dwight9339/spooky_box_proto/host/README.md

# Spooky Bench host utility

Phase 1A provides Windows serial discovery, bounded Pico UART capture and
LOG/DIAG queries on the separate target CDC port. Phase 1B adds pinned Windows
OpenOCD probe/reset and manifest-based paired flashing with integrated UART
capture. Phase 2 adds a supervised `test boot-smoke` verdict for an IpcSmoke
pair. Phase 3 adds a supervised `test ipc-load` recording workload,
`wav inspect` for CRC-verified retrieval and local three-channel analysis, and
`wav align` for offline radio-to-microphone timing measurement, and `test sd-basic`
for bounded scratch-file write/read verification with cleanup. `test
recording-regression` composes flash, recording, retrieval and health checks into
the single unattended baseline regression. See
[controls](../docs/procedures/spooky-bench-controls.md),
[boot smoke](../docs/procedures/spooky-bench-boot-smoke.md), and
[IPC load](../docs/procedures/spooky-bench-ipc-load.md), and
[WAV inspection](../docs/procedures/spooky-bench-wav-inspection.md),
[WAV alignment](../docs/procedures/spooky-bench-wav-alignment.md),
[SD basic](../docs/procedures/spooky-bench-sd-basic.md), and
[recording regression](../docs/procedures/spooky-bench-recording-regression.md). Run
`spookybench --json ...` for one machine-readable result.

`diag identity` reads the M7-reported build token, retained boot epoch, reset flags
and compatible capability bits. New manifests compare that observation with the
identity embedded in the staged CM7 ELF; legacy schema-v1 images remain supported
with target identity explicitly unavailable.

See [installation and usage](../docs/procedures/spooky-bench-setup.md) and the
[implementation plan](../docs/history/2026-09-23-spooky-bench-plan.md).

Tests use simulated devices; no board connection is required:

```powershell
host/.venv/Scripts/python.exe -B -m unittest discover -s host/tests -v
```

The environment must include the pinned Spookyprobe package. The setup procedure
exports its committed source without modifying the sibling repo. Tests do not
depend on that repo remaining present once the package is installed.
