dwight9339/spooky_box_proto/docs/design/usb-cli.md

# USB CDC CLI contract

The command interface on the target's USB CDC port. It is a bring-up implementation of
the application command model in the [architecture](architecture.md#application-model):
physical controls will eventually use the same command handling and safety policy.
Wiring and device configuration are in [prototype hardware](prototype-hardware.md).
Diagnostic commands (`LOG`, `DIAG`) are specified in
[Spookyprobe v1](spookyprobe-v1.md); `IPC STATUS` in the
[diagnostic IPC contract](ipc-diagnostic-contract.md).

## Transport

The port enumerates as a CDC ACM device, distinct from the Spooky Probe's serial port.
Windows may display it as `USB Serial Device`. The baud-rate setting is ignored. On
connection it prints:

```text
Spooky Box USB CLI ready
Type HELP for commands.
```

Commands are ASCII lines terminated by CR, LF, or CRLF:

```text
HELP
STATUS
BAND
BAND FM
BAND AM
BAND SW
BAND LW
TUNE 99100
UP
DOWN
CLASSIC
CLASSIC RUN
CLASSIC PAUSE
CLASSIC TOGGLE
CLASSIC DIR
CLASSIC RATE +1
CLASSIC DIST -2
CLASSIC EDGE 1
VOLUME READ
MAG READ
MAG STATUS
MAG STREAM START 100
MAG STREAM STOP
EMF READ
EMF STATUS
EMF ZERO
EMF STREAM START 100
EMF STREAM STOP
RECORD STATUS
RECORD RESULT
RECORD TIMELINE
RECORD LATENCY
RECORD START 60
RECORD STOP
SD STATUS
SD INFO
SD REINIT
SD STRESS 64 1
SD STRESS STOP
SD CLEAN
SD FORMAT
SD FORMAT CONFIRM
WAV FETCH FIELD/F0001/AUDIO000.WAV
WAV ABORT
UI STATUS
UI WATCH START
UI WATCH STOP
UI LEDS
UI MATRIX PROBE
UI MATRIX ANIMATE
UI MATRIX ORIENT
UI MATRIX FEEDBACK
UI MATRIX FEEDBACK ON
UI MATRIX FEEDBACK OFF
UI MATRIX TRAIL ON
UI MATRIX TRAIL OFF
UI DISPLAY TEST
UI DISPLAY TEST 0
UI DISPLAY TEST 2
UI DISPLAY OFF
UI OFF
SLEEP START
DIAG IDENTITY
DIAG LATENCY
```

HELP is streamed in short lines.

## Command input and flow control

Commands are lines of at most 63 characters, ended by CR or LF. The firmware handles
one line per foreground pass, and only once the previous reply has gone out. Received
bytes wait in a 256-byte ring. The CDC OUT endpoint is re-armed only while another
full 64-byte packet fits in it; otherwise the device NAKs the host, which holds its
data until the firmware has drained the ring (`full_spooky_proto-8lw.24`). A client
that sends faster than the firmware answers is slowed down instead of losing bytes, so
every complete line it sends gets exactly one reply. A line longer than 63 characters is
answered `ERR command too long`. While the endpoint is paused, the host retries
continuously. The HAL enables an interrupt for every NAKed OUT token; the firmware masks
it when the interface is configured, so a pause costs no CPU. Unmasked, those
interrupts starved a recording into an overrun during a command flood
([evidence](../evidence/2026-10-02-usb-flow-hostless-battery.md)).

`DIAG USB` reports the receive counters since the last enumeration:

```text
OK DIAG USB RX_PACKETS=... RX_PAUSES=... RX_OVERRUNS=0 RX_QUEUED=... RX_PAUSED=0|1
```

`RX_PAUSES` counts how often flow control held the host back. `RX_OVERRUNS` counts
packets that did not fit and were truncated; it stays zero unless flow control fails.

## Target build identity

`DIAG IDENTITY` is a bounded read-only query owned by M7. Its single response is:

```text
OK IDENTITY V=1 CORE=7 BUILD=<token> BOOT=<u32> RESET=<u32> CAPS=<u32>
```

`BUILD` is the 1..128 character ASCII token supplied as `SPOOKY_BUILD_ID` when the
paired firmware was configured. `BOOT` is a nonzero counter retained in RTC backup
registers and advanced once per M7 startup; a changed value during one bench
operation proves that the target restarted. It is not a globally unique boot ID and
may restart after loss or reset of the backup domain. `RESET` is the startup snapshot
of `RCC_RSR`, taken before firmware clears the reset flags.

`CAPS` bit 0 declares identity reporting, bit 1 the retained boot epoch, bit 2 the
diagnostic service, bit 3 WAV protocol v1, and bit 4 the opt-in IPC smoke service.
Consumers must reject unsupported schema/core values and must not infer target or
probe firmware identity from USB descriptors or package versions.

## Command admission while recording

The CLI and future physical-control commands share the recording-safe policy from
[decision 0008](../decisions/0008-recording-safe-command-policy.md). `RECORD START`
and `RECORD STOP` are admitted to the bounded M7 event queue as external commands;
if its non-reserved capacity is exhausted, the CLI replies `ERR BUSY` and changes
nothing. Session actions then run through the authoritative Session machine.

`DIAG LATENCY` streams the recording-only maximum and violation count for every
foreground service. The budget table and queue-headroom rationale are in
[foreground latency](foreground-latency.md).

While Preparing, Recording or Finalizing, sleep, another recording start, SD maintenance, WAV
transfer, `EMF ZERO`, the `UI LEDS`, `UI MATRIX ANIMATE`, `UI MATRIX ORIENT`,
`UI MATRIX FEEDBACK ON` and `UI DISPLAY TEST` patterns, and radio band changes (except in the `BandSwitchQual` preset) are rejected before their service handlers
run. Status and diagnostic reads, `CLASSIC` parameter commands and `MONITOR PTT` remain available. Every policy rejection is a
numeric `COMMAND_REJECTED` diagnostic and returns one stable `ERR` line. No command
is deferred until the recording ends.

## Radio

`BAND` reports the current receiver band and its tuning range. `BAND FM`,
`BAND AM`, `BAND SW`, and `BAND LW` switch receiver function, restore the last
frequency used in that band, and briefly mute the headphones while the Si4735
is power-cycled. The defaults, ranges, and `UP`/`DOWN` increments are:

| Band | Default | Range (kHz) | Step |
| --- | ---: | ---: | ---: |
| FM | 99100 kHz | 87500..108000 | 100 kHz |
| AM | 1000 kHz | 520..1710 | 10 kHz |
| SW | 6000 kHz | 2300..23000 | 5 kHz |
| LW | 198 kHz | 153..279 | 9 kHz |

The antenna path follows the band automatically. `TUNE` always accepts an integer
frequency in kHz. The Radio machine validates it against the band the tune will run
in, so a `TUNE` sent right after a `BAND` command is checked against the new band;
FM values are rounded to the Si4735's nearest 10 kHz command unit. A successful tune returns the band, actual
frequency, RSSI, SNR, and valid-channel flag, for example:

```text
OK RADIO BAND=FM FREQ=99100 kHz (99.100 MHz) RSSI=7 SNR=2 VALID=0
```

`TUNE`, `UP`, `DOWN` and `BAND <band>` go to the Radio machine
([RadioSm](behavior/RadioSm.puml)) through the bounded M7 event queue. If the queue
refuses the command, the reply is `ERR BUSY` and nothing changes. Otherwise the reply
comes when the command's outcome is known: neither a tune nor a band switch holds
the CLI or the foreground loop while the receiver settles or power-cycles. One tune
or band switch is in flight at a time, and one newer command waits behind it. A command that arrives while another is waiting
replaces it, and the replaced command is answered `OK RADIO SUPERSEDED`, so a client
that streams targets (for example a Pd slider) gets exactly one reply per line and
no backlog builds up. Other replies are `ERR RADIO tune failed` (bus error, or no
completion within 2 s), `ERR RADIO abandoned; radio fault` for a command still
waiting when the radio faults, and `ERR RADIO audio path is not running` once the
radio is out of service. A `TUNE` that waits behind a band switch is checked
against the new band when the switch completes.

A band switch that fails holds the receiver in reset and keeps the output muted. Radio
capture keeps running with silence in the radio channels, so a recording in progress
continues with its microphone track and an open gap
([decision 0004](../decisions/0004-radio-track-continuity-across-transitions.md)).
Until a reset, `STATUS` and every radio command answer
`ERR RADIO band switch failed; reset required`, a `RADIO_FAULT` diagnostic sets
`HAS_FAULT`, and `RECORD START` is refused with `ERR RECORD radio audio path is not
running`.

In-band tuning (`TUNE`, `UP`, `DOWN` and Classic's jumps) is allowed while
recording ([decision 0003](../decisions/0003-radio-control-during-recording.md);
[evidence](../evidence/2026-10-16-tune-guard-lift.md)). Each tune is stored in the
session's event log, and the radio track inside a retune interval holds receiver output
that is not a measurement ([decision 0015](../decisions/0015-raw-radio-track-during-in-band-tunes.md)).
Band changes are still rejected while recording, with
`ERR RADIO band changes disabled while recording`, until `full_spooky_proto-54w.12`
qualifies them. The opt-in `BandSwitchQual` preset allows them while recording, for
that qualification only. It also accepts `BAND FAIL`, which makes the next band switch
fail after its receiver power-up command, as if the receiver had answered an error;
the reply is `OK RADIO next band switch fails at POWER_UP`.

During a band switch the audio path's stream gate is closed. Each radio half-buffer
then reaches the recorder as digital silence of the same length, so the radio and
microphone tracks keep the same block count. The monitor plays silence, and the
activity detector gets no measurement
([decision 0004](../decisions/0004-radio-track-continuity-across-transitions.md)).
When the gate reopens, the gap's first and last silenced frames are exact.

- **Session event log:** gap start (band before) and gap end (band after and
  frequency).
- **UART log:**

```text
[gap] start=1:5120000 end=1:5135359 band=FM->AM freq=1000 missed=0
```

`missed` counts gaps whose edges were overwritten before the foreground saw them.

The radio is also tuned by the Classic scan engine, which runs from power-on (next
section). Band and frequency are shared: a CLI `TUNE`, `UP`, `DOWN` or `BAND` moves
them, and a running Classic continues from wherever the CLI tuned. Classic waits for
every CLI radio command to be answered before it computes its next jump. A bench step
that needs a fixed frequency sends `CLASSIC PAUSE` first.

## Classic scan engine

The device boots with the Classic engine running on FM
([spec 001](../../spec/specs/001-classic-scan-engine/spec.md),
[decision 0016](../decisions/0016-classic-scan-motion.md)). Until physical controls
are wired, the CLI issues the same Classic commands as the controls of the control
map, through the bounded M7 event queue:

| Command | Effect | Control |
|---|---|---|
| `CLASSIC` | Report the published state | |
| `CLASSIC TOGGLE` | Run or pause | C-103 |
| `CLASSIC RUN`, `CLASSIC PAUSE` | Run or pause; no change if already in that state | |
| `CLASSIC DIR` | Toggle the scan direction | C-105 |
| `CLASSIC RATE <n>` | Move the jump rate `n` detents (signed) | C-104 |
| `CLASSIC DIST <n>` | Move the current band's jump distance `n` detents | C-106 |
| `CLASSIC EDGE <n>` | Move the edge behavior `n` detents through wrap, bounce, stop | C-110 |
| `CLASSIC HOLD <n>` | Move the activity hold time `n` detents through 0 (off), 1, 2, 3, 5, 8, 10, 15, 20 and 30 s | C-111 |
| `CLASSIC ACTIVITY` | Report the radio onset measurement behind the hold (bench diagnostic) | |

Each command is answered after it is applied, with the state, and `CLASSIC` reports
the same line:

```text
OK CLASSIC STATE=RUNNING REASON=NONE BAND=FM FREQ=99100 CH=116/206 DIR=UP RATE=120 SET=120 LIMITED=0 DIST=1 DIST_KHZ=100 EDGE=WRAP HOLD=0 JUMPS=0 REFUSED=0 FAILED=0 HOLDS=0
```

`STATE` is `RUNNING`, `HOLDING`, `PAUSED`, `SWEEP_COMPLETE` or `UNABLE`. `UNABLE`
replaces `RUNNING` and `HOLDING` while Classic cannot retune, and `REASON` says why:
`RADIO_STOPPED`, `RADIO_FAULTED`, or `SESSION` while the command policy rejects tuning
during a session. Classic then issues nothing and does not retry; it resumes one jump
period after tuning is possible again. `RATE` is the rate in effect and `SET` the
setting; `LIMITED=1` means the band's maximum rate applies. `FREQ` and `CH` are the
last completed tune. `HOLD` is the hold time in seconds, 0 when off. `JUMPS` counts
jumps, `REFUSED` tune commands the queue refused (the landing waits one period),
`FAILED` tunes answered as failed, rejected, superseded or abandoned, and `HOLDS`
holds started. A full queue answers `ERR BUSY` and malformed arguments the usage
line. Classic commands are allowed during a session.

`HOLDING` means Classic is staying on its landing because the radio audio has onsets
(decision 0016 items 17 to 20): a hold starts on an onset of at least medium size,
lasts while onsets of any size follow within 1.5 s, ends at the hold time at most,
and happens at most once per landing. A hold never shortens a dwell: when it ends
before the next jump is due, the jump keeps its time. Onsets come from the decision
0013 detector, fed one level per radio half-buffer; from each tune or band switch
until the radio is seen settled, plus one half-buffer except after FM and AM tunes,
blocks are not measured
([decision 0015](../decisions/0015-raw-radio-track-during-in-band-tunes.md)), so no
hold starts there. `CLASSIC ACTIVITY` replies:

```text
OK CLASSIC ACTIVITY VALID=1 RETUNING=0 RATIO_X100=104 ONSETS=12/3/1 BLOCKS=56230 MEASURED=55120 DROPPED=0 HIGH=5 RETUNES=310
```

`VALID=1` means the latest radio block was measured and arrived within 100 ms.
`RETUNING=1` while a retune interval is open. `RATIO_X100` is the detector's
fast/slow level ratio times 100. `ONSETS` counts small, medium and large onsets since
boot. `BLOCKS` and `MEASURED` count half-buffers given to the detector and those
measured. `DROPPED` counts half-buffers the 32-entry feed refused because the
foreground had not drained it, and `HIGH` is the most waiting at once. `RETUNES`
counts retune intervals started.

Every change of run state (with its reason), direction (including a bounce reversal),
rate, distance, edge behavior or hold time is published as one line on the AUX UART
log, with the millisecond tick and the radio sample-timeline position as `epoch:frame`
([decision 0012](../decisions/0012-common-audio-sample-timeline.md)):

```text
[classic] t=48211 pos=1:2312448 DIRECTION STATE=RUNNING REASON=NONE DIR=DOWN RATE=120/120 LIMITED=0 DIST=1 EDGE=BOUNCE HOLD=0 BAND=FM FREQ=107900
```

Routine jumps are not events; each completed tune is logged by the radio as usual. A
hold is two `RUN_STATE` lines, `STATE=HOLDING` and then `STATE=RUNNING` (or
`PAUSED`), whose ticks give its length. Each radio onset the Classic service receives
is also logged, with the frequency of the last completed tune, whether or not the
hold is on, so a bench trial can see where onsets fall (decision 0016 item 23):

```text
[activity] t=27347 ONSET=SMALL BAND=FM FREQ=89200
```

## Volume

The wheel potentiometer is sampled every 10 ms. Firmware applies a low-pass filter and
one-dB update hysteresis, maps the knob from mute through 0 dB headphone gain, and
continues to honor the headphone jack detect. `VOLUME READ` (also accepted as
`VOLUME` or `VOLUME STATUS`) forces a fresh ADC sample and reports its current level:

```text
OK VOLUME ADC=32768 LEVEL=50% ATTEN=-26.5 dB MUTED=0
```

## Monitor and PTT

The headphone monitor plays the radio. PTT (C-016, C-017; decision 0028) fades the
radio out of the monitor over `SPOOKY_PTT_RAMP_FRAMES` (240 frames, 5 ms) and back in
on release; both raw tracks keep recording unchanged. The microphone is not monitored.
`MONITOR PTT ON` and `MONITOR PTT OFF` set PTT through the same command-policy action
as Button 1, allowed in every session state. A CLI press is not reconciled: it lasts
until `MONITOR PTT OFF`. Repeating the current state changes nothing. `MONITOR` (or
`MONITOR STATUS`) reports, and each `MONITOR PTT` command replies with the same line:

```text
OK MONITOR PTT=1 GAIN_Q15=0 RAMP_FRAMES=240 MIC=OFF PRESSES=3 RELEASES=2 UNSTAMPED=0 LAST_ON=1:1843200 LAST_OFF=1:1795584 UNCERTAINTY=3600
```

| Field | Meaning |
| --- | --- |
| `PTT`, `GAIN_Q15` | PTT is on; the radio's monitor gain now, 32768 unity and 0 silent |
| `RAMP_FRAMES`, `MIC` | Frames of a full fade; the microphone is not in the monitor |
| `PRESSES`, `RELEASES` | PTT changes since boot |
| `UNSTAMPED` | Changes made while the radio stream was not running, so not stamped |
| `LAST_ON`, `LAST_OFF` | The latest press and release as `epoch:frame` on the radio timeline (decision 0012), `NONE` before the first |
| `UNCERTAINTY` | Frames before the stamp in which the change may have happened: one foreground pass (decision 0012 item 6). It excludes the input path's own latency |

Sessions do not store PTT stamps yet; that belongs to the session format
(`full_spooky_proto-hpq.3`).

## Magnetometer and EMF

`MAG READ` wakes the sensor, returns one X/Y/Z result in microtesla plus raw
codes and conversion status, then puts it back to sleep. `MAG STREAM START`
starts a 100 ms stream; an optional period from 50 through 60000 ms can be
provided after `START`. `MAG STREAM STOP` stops the stream and returns the
sensor to sleep. At boot, firmware prints one sample. Example output:

```text
OK MAG STREAM START period=100 ms
MAG X=24uT Y=-48uT Z=101uT RAW=6,-12,25 SET=3 READY=1 DIAG=0
OK MAG STREAM STOP; sensor sleeping
```

The prototype `EMF` value is a magnetic anomaly metric, not electromotive force in
volts. It is the absolute difference between the 3D field magnitude and a slowly
adapting ambient baseline:

```text
EMF = abs(sqrt(X*X + Y*Y + Z*Z) - baseline)
```

The initial boot sample seeds the baseline. A low-duty background reading
updates it every five seconds by 1/16 of the difference, giving an effective
time constant of roughly 80 seconds, but only while the field is quiet: when
the change from baseline is 100 µT or more the update is skipped
([decision 0019](../decisions/0019-matrix-emf-four-buckets-and-quiet-baseline.md)).
This follows slow ambient drift, and a magnet held near the sensor cannot drag
the baseline and leave a false reading once it is taken away. A lasting change
of 100 µT or more stays shown until `EMF ZERO`. `EMF READ` returns only the single
metric, `EMF STATUS` also shows the current magnitude and baseline, and
`EMF ZERO` immediately resets the baseline to the current field. The EMF
stream accepts the same optional 50..60000 ms output period as the raw
magnetometer stream:

```text
EMF=37uT
OK EMF=37uT FIELD=4842uT BASELINE=4805uT
OK EMF ZERO BASELINE=4842uT
```

## UI board

These commands exercise the M7 bring-up drivers; see
[decision 0001](../decisions/0001-initial-ui-and-bus-ownership.md) for ownership.

`UI STATUS` reports the unmodified GPIO levels and accumulated encoder counts:

```text
OK UI RAW BTN0=1 BTN1=1 ENC0=A1B1S0/0 ENC1=A1B1S0/0 ENC2=A1B1S0/0 ENC3=A1B1S0/0 WATCH=0 LEDS=IDLE MATRIX_EN=0 DISPLAY=OFF DROPPED=0
```

`UI WATCH START` resets counts and reports events. Pushbuttons are debounced for
15 ms. Encoder A/B is sampled by the 1 kHz SysTick interrupt; completed detents are
handed off to the foreground USB task. The observed phase order is reported as
`DIR=CW` or `DIR=CCW`, and `STEPS` groups any detents completed between foreground
service calls:

```text
OK UI WATCH START counts-reset=1 debounce=15-ms sample=1-kHz
UI EVENT BTN0 PRESSED RAW=0
UI EVENT BTN0 RELEASED RAW=1
UI EVENT ENC0 DIR=CW STEPS=1 COUNT=1 AB=11
UI EVENT ENC0_BTN PRESSED RAW=1
```

`UI LEDS` drives all fourteen channels one at a time for 350 ms: the two
standalone button LEDs first, followed by the twelve encoder RGB channels. It
then restores every low-side-driver input low. `UI OFF` aborts a chase, stops input
event reporting, disables the matrix, turns off and resets the display, and forces
all LED controls low.

`UI MATRIX PROBE` raises PB5, waits 10 ms, and probes only the IS31FL3741
address `0x30`. It does not initialize or illuminate the matrix, and always returns
PB5 low:

```text
OK UI MATRIX ACK address=0x30 EN-restored=0
```

`UI MATRIX ANIMATE` initializes the controller at a conservative global current and
runs a color-changing comet through all 81 logical pixels with a dim three-pixel
tail, taking about six seconds. It then clears the PWM registers, enters software
shutdown, and returns PB5 low. `UI OFF` aborts it immediately through the hardware
enable pin.

```text
OK UI MATRIX ANIMATE START logical=9x9 physical-cols=2..10 step=70-ms current=0x40
OK UI MATRIX ANIMATE PASS pixels=81 logical=9x9 blanked=1 EN=0
```

`UI MATRIX ORIENT` initializes the controller and lights three logical corners: red
at top-left (0,0), green at top-right (8,0) and blue at bottom-left (0,8). It shows
how the matrix is mounted; `UI OFF` clears it. The matrix on the bench UI board is
mounted rotated 180 degrees from the original panel mapping, and the M7 matrix writer
corrects for it, so every logical coordinate appears the right way up.

```text
OK UI MATRIX ORIENT red=(0,0) green=(8,0) blue=(0,8); UI OFF clears
```

### Matrix feedback

`UI MATRIX FEEDBACK ON` starts the M7 matrix feedback of
[decision 0013](../decisions/0013-matrix-emf-radio-and-status-mapping.md), with the
EMF buckets, baseline and trail default of
[decision 0019](../decisions/0019-matrix-emf-four-buckets-and-quiet-baseline.md):
the expanding square coloured by the EMF bucket, row kicks on radio onsets, and the
recording border. Feedback is off at boot. It holds the matrix, so `UI MATRIX PROBE`,
`ANIMATE` and `ORIENT` answer `ERR UI MATRIX busy ... feedback=1` until
`UI MATRIX FEEDBACK OFF` or `UI OFF` releases it. While it runs, the magnetometer
samples every 100 ms for the EMF level.

The writer compares each frame with what the matrix shows and sends only the rows
that changed, as I2C2 register runs (24 bytes for columns 0 to 7 and 3 bytes for
column 8 of a row). A foreground pass keeps sending runs until 2 ms have been spent,
so one pass can send several. I2C2 runs in fast mode (about 360 kHz) for this; see the
[CubeMX register](cubemx-reconciliation.md).

On normal images the matrix goes dark while the recorder captures: the adapter turns
it off through the enable pin, with no I2C2 traffic, and writes the whole frame again
when the capture ends. The opt-in qualification build
(`-DSPOOKY_MATRIX_RECORDING_QUALIFICATION=ON`) keeps the matrix writing during a
capture, so the recording border shows, and starts the feedback at boot so a
`test recording-regression` run exercises it. The magnetometer is still not read
during a capture, so in that build the outline turns dim grey while recording.

`UI MATRIX FEEDBACK` alone reports the status. The `ON`, `OFF` and `TRAIL` commands
answer with the same line:

```text
OK UI MATRIX FEEDBACK=1 TRAIL=0 SUSPENDED=0 EMF=VALID BUCKET=0 EMF_UT=21 FRAMES=132 RUNS=1261 FAILED=0 SUPERSEDED=0 DROPPED_STEPS=0 PENDING=0 RUN_US_MAX=1756 SUSPENSIONS=0
```

| Field | Meaning |
| --- | --- |
| `FEEDBACK`, `TRAIL` | Feedback running; trail on (seven-step loop) or off (six steps) |
| `SUSPENDED`, `SUSPENSIONS` | Matrix dark for a capture now; captures since feedback started |
| `EMF`, `BUCKET`, `EMF_UT` | EMF level state (`VALID`, `NO_SAMPLE`, `NO_BASELINE`, `STALE`, `SENSOR_FAULT`), its bucket, and the newest change from baseline |
| `FRAMES`, `SUPERSEDED` | Frames composed; frames replaced before all their runs were written |
| `RUNS`, `FAILED`, `PENDING` | Register runs written, failed, and still to write for the current frame |
| `DROPPED_STEPS` | Animation steps skipped to keep the tempo, including the catch-up after a capture |
| `RUN_US_MAX` | Longest single run, timed with the cycle counter |

`UI MATRIX TRAIL ON` and `OFF` choose the trail, which is off by default; the setting is
kept while feedback stops and starts. Three consecutive failed runs stop the feedback
with `[matrix] feedback off: I2C2 writes failed`.

`UI DISPLAY TEST` draws a static test image with the confirmed zero-column mapping
and reports:

```text
OK UI DISPLAY TEST PASS controller=SSD1309 resolution=128x64 offset=0 spi=8-MHz
```

The image has a one-pixel border, both diagonals, a center cross, a filled square in
the upper-left corner, an outline square in the upper-right, three descending
horizontal bars at lower left, and vertical bars at lower right. `UI DISPLAY TEST 0`
explicitly selects the confirmed mapping; `UI DISPLAY TEST 2` selects the alternate
two-column mapping as a diagnostic option for other SSD1309 variants.
`UI DISPLAY OFF` sends display-off, asserts reset low, and leaves chip select high.

## Recording

`RECORD START [seconds]` records radio and microphone audio into one WAV file.
Without `seconds` it is open-ended and runs until `RECORD STOP` or a storage
limit. Supplying 1..3600 seconds keeps the bounded form used by bench tests. Files are named
`REC000.WAV` through `REC999.WAV`, selecting the first unused name, and are retained
on the card. The interleaved channel order is:

1. radio left
2. radio right
3. PDM microphone

The file is standard PCM at 48 kHz, 16 bits, and three channels: 288,000 bytes/s, or
about 17.3 MB/minute. Firmware combines both input streams into 4096-frame blocks and
writes 24 KiB every 85.33 ms. Each input has an eight-block queue, providing about
683 ms of write-stall tolerance.

The start follows decision 0012. Immediately before the microphone DMA starts, with
interrupts masked for a few microseconds, the firmware reads the radio DMA position,
enables radio capture and starts the microphone DMA. The recorder then drops the radio
frames received before that position plus the microphone start latency *C*
(`SPOOKY_RECORD_MIC_LATENCY_FRAMES`). Decision 0017 keeps *C* at 0: radio frame 0 is
the radio frame in progress when the microphone DMA starts. Microphone sample 0
represents sound from a constant, unmeasured interval after that, estimated by
arithmetic at about 2 to 4 frames plus the microphone's own delay. The alignment is
qualified as repeatable: loopback recordings agreed within 0.3 frames in one boot and
1.4 frames across a reset, with no drift over ten minutes
([evidence](../evidence/2026-10-02-recording-start-alignment.md)). Before this change
the radio track could start up to one 512-frame radio DMA half (about 10.7 ms) before
the microphone.

Capture starts only after the file is preallocated, so no allocation search runs while
recording. `RECORD START` mounts and checks the card and replies
`OK RECORD PREPARING prealloc-kib=...`; the Session state is then Preparing, which
follows the recording command policy. The following foreground passes make the
session folder, write its manifest, create the audio file and search the FAT for one
contiguous free run long enough for the preallocation. Each pass spends about
`SPOOKY_RECORD_PREPARE_STEP_MS` (32 ms by default) and always makes progress (one
directory call or one FAT sector).

Every recording is a Field session folder
([decision 0030](../decisions/0030-field-session-folder-and-event-log.md); layouts in
[session format](session-format.md)):

- **Folder:** `/FIELD/Fnnnn`, numbered from `/FIELD/INDEX.TXT` (`next=<n>`). A missing
  or unreadable index starts the search at 1, and each taken number costs one
  directory call.
- **`MANIFEST.TXT`:** written with `state=recording` while preparing, and rewritten
  with `state=ended`, the end reason, the frame total and the timeline origin once the
  audio is finalized.
- **Audio:** `AUDIO000.WAV`, so the reply's `file=` is a path such as
  `FIELD/F0007/AUDIO000.WAV`.
- **Event log:** `EVENTS.BIN`, created with its header while preparing.
  - **Producers:** while the session captures, it receives session start and end,
    tune start and end, PTT and every Classic event, each stamped on the session
    timeline. At frame 0 it also holds a Classic snapshot, PTT if held, and any tune in
    flight.
  - **Queue:** records wait in a 64-record queue. Recorder passes with no audio work
    write each full 512-byte sector, and write and sync a partial one whose oldest
    record has waited 2 s.
  - **Loss:** a full queue drops the newest record, and the next accepted record
    follows an events-lost record and a fresh snapshot.
  - **Write failure:** a failed write reports
    `ERR RECORD event log write failed ...; recording continues` and counts the
    waiting records as lost.
  - **At the end:** the recorder posts session end, writes what remains, and reports
    `RECORD EVENTS written=... lost=... queue-max=.../64 write-max=...ms failed=0|1`
    after `RECORD DIAG`. The manifest records `events_written` and `events_lost`.
- **Cancelled start:** a start that never captures removes its audio, manifest and
  folder. The number is not reused.
- **Old files:** root `REC###.WAV` files from earlier firmware stay readable, and
  recordings no longer create them.
The preallocation is the first 60 seconds, or the whole requested duration when it is
shorter, but never more than the free space above the card reserve. The search starts
at the volume's next-free hint and wraps once around the volume. Once the run is
found, the file is allocated and its header written; `OK RECORD PREPARED` reports the
time spent in each step, and `OK RECORD START` follows when capture starts:

```text
OK RECORD PREPARED file=FIELD/F0006/AUDIO000.WAV prealloc-kib=16875 open=...ms folder=...ms manifest=...ms events=...ms create=...ms search=...ms fat-sectors=... allocate=...ms steps=... step-max=...ms elapsed=...ms
```

When no contiguous run is long enough anywhere on the volume, the start is refused
and the empty file deleted:
`ERR RECORD free space too fragmented largest-run-kib=... need-kib=... fat-sectors=...`.
Without a contiguous allocation the file would grow one cluster at a time, and FatFs
would search the FAT inside a block write; on a nearly full, fragmented card one such
write took 1.4 s and overran the queues
([trial](../evidence/2026-10-01-prealloc-search-trial.md)). `RECORD STOP` while preparing cancels the start and
deletes the empty file (`OK RECORD STOP cancelled before capture; no file kept`).
`RECORD STATUS` reports `OK RECORD PREPARING file=... fat-sectors=... elapsed=...ms`
during preparation. Volumes other than FAT32 skip the stepped search and rely on
FatFs `f_expand`, whose FAT12/16 tables are at most 256 sectors.

A recording longer than its preallocation (open-ended, or timed beyond 60 s) grows
past it one cluster at a time. FatFs then takes the first free cluster after the file,
scanning forward through any used clusters inside that block write. To keep that scan
short, the recorder reads the FAT ahead of the file during the recording, one sector
(128 clusters, about 14.5 s of audio with 32 KiB clusters) at a time in idle
foreground passes, keeping about 30 s ahead of the write position. It counts the free
clusters the file can reach across used stretches of at most
`SPOOKY_RECORDING_MAX_GAP_FAT_SECTORS` FAT sectors (16 by default: 2048 clusters, about
25 ms of FatFs reading inside one write). The recording may fill only the space
verified that way. When a longer used stretch, or the end of one lap around the FAT,
leaves no further reachable cluster, the recording finalizes before the next block
would need one and reports the fault:
`ERR RECORD ABORT file=... reason=free space fragmented finalized=1`. `RECORD LATENCY`
reports `runway=none|open|end|failed`, the FAT sectors read ahead (`fat-ahead`) and the
longest used stretch crossed in clusters (`gap-max`). The preallocated length is the
build setting `SPOOKY_RECORDING_PREALLOC_SECONDS`, and the step budget is
`SPOOKY_RECORD_PREPARE_STEP_MS`.

The step budget bounds the FAT search but not a single directory call: each folder
creation, the file creation and the deletion of a discarded file scan a directory in
one FatFs call. Session folders keep the card root small; `/FIELD` grows by one entry
per session. Root measurements before session folders: On a root of about 1,900 entries they took 60-116 ms, against 33 ms or
less with 83 files ([evidence](../evidence/2026-10-02-stepped-preallocation.md);
`full_spooky_proto-jjy.18`).

At open, the recorder queries free space once and then subtracts each successful
matched-block write from that cached budget. It does not run `f_getfree` on the
recording path. Before another block would leave less than the configured reserve,
it finalizes the current valid file and reports `card full` as a fault. The reserve
defaults to one minute of three-channel audio (17,280,000 bytes), plus the configured
rolling-capture window and any additional finalization allocation. The rolling
contribution is zero until `full_spooky_proto-hpq.2` chooses and implements that
window; finalization currently rewrites the allocated header and truncates, so its
additional data-allocation contribution is zero. These three build settings are
`SPOOKY_RECORDING_CARD_RESERVE_SECONDS`,
`SPOOKY_ROLLING_CAPTURE_RESERVE_BYTES`, and
`SPOOKY_RECORDING_FINALIZE_RESERVE_BYTES`.

Until a session continues into a next audio part (`full_spooky_proto-hpq.12`), a
recording also finalizes cleanly before another block would exceed the RIFF/WAV 32-bit
size limit (about 4 hours 8 minutes), and its manifest reports `audio_parts=1`.

The requested duration is rounded up to the next 4096-frame block, so a 60-second
request produces about 60.075 seconds of audio:

```text
OK RECORD PREPARING prealloc-kib=16875
OK RECORD PREPARED file=FIELD/F0001/AUDIO000.WAV prealloc-kib=16875 ...
OK RECORD START file=FIELD/F0001/AUDIO000.WAV duration=open format=48000Hz/16-bit/3ch [radio-L,radio-R,mic]
...
OK RECORD PASS file=FIELD/F0001/AUDIO000.WAV ... reason=stopped
RECORD DIAG queues radio=.../8 pdm=.../8 max-write=...ms peaks=...,...,... margin=OK|LOW
RECORD EVENTS written=... lost=0 queue-max=.../64 write-max=...ms failed=0
```

`RECORD STATUS` reports progress, current queue depths, the longest SD write and the
storage margin.

The storage margin (decision 0014) becomes `LOW` once either audio queue's high-water
mark reaches 4 of 8 blocks or a single SD write takes 341 ms or more, half the
queue headroom. It latches for the rest of the recording, appears in `RECORD STATUS`
and `RECORD DIAG`, and records one `STORAGE_MARGIN` diagnostic event. It is a warning,
not a fault: it does not set `HAS_FAULT` or stop the recording. The thresholds are the
build settings `SPOOKY_STORAGE_MARGIN_QUEUE_BLOCKS` and `SPOOKY_STORAGE_MARGIN_WRITE_MS`
until the media survey fixes them.
`RECORD LATENCY` reports, for the current or last recording, the number of block
writes, the longest `f_write`, the longest block conversion before it, and a
histogram of `f_write` durations in 10 ms bins (0-9 ms through 60-69 ms, then
70 ms and above). Counters reset at `RECORD START`. Its fields `usb-superseded`,
`usb-lost` and `usb-detached` are cumulative since boot and describe the recorder
reply queue below.

Recorder replies make one nonblocking submission attempt and otherwise wait in a
four-line queue that is drained one line per loop pass. Only the newest
`RECORD progress` line stays queued: a newer one replaces it, and any other reply that
finds the queue full evicts it. `usb-superseded` counts progress lines removed this
way. Only when the queue holds four non-progress replies does a new reply evict the
oldest one; that counts in `usb-lost` and records a `USB_BACKPRESSURE` fault. A host
that stops reading during a recording therefore receives the outcome (`OK RECORD PASS`
or `ERR RECORD ABORT`) and `RECORD DIAG` when it resumes, after at most one stale line
already in transfer and the newest progress line. Queued replies are sent as soon as
the host polls again, so a host that discards received data when it opens the port
(pyserial on Windows calls `PurgeComm` in `open()`) can lose them. Such a host
recovers the outcome with `RECORD RESULT`.

The queue holds lines only for a host that has the CDC interface configured
(`full_spooky_proto-8lw.20`). With no host attached, as in a field recording, the
recorder queues nothing. When the host goes away, the lines already queued are
discarded rather than delivered stale to the next host. Both cases count in
`usb-detached`, are not faults and leave `HAS_FAULT` unset; the lines still appear on
the UART log, and `RECORD RESULT` keeps the outcome.

`RECORD RESULT` is a read-only query, accepted in every session state, that reports
the last finished recording since boot:

```text
OK RECORD RESULT NONE
OK RECORD RESULT seq=2 outcome=PASS file=REC075.WAV frames=286720 bytes=1720320 elapsed=6025ms finalized=1 reason=stopped
```

`seq` counts finished recordings since boot. `outcome` is `PASS` exactly when the
pushed line was `OK RECORD PASS`; otherwise it is `ABORT`, including a clean stop
whose finalization failed. `reason` is last and may contain spaces. The record is
written before the pushed outcome line, so it is never older than that line. While a
recording is active the reply still describes the previous one; a host that started
a recording matches `file` (and `seq`) before treating the result as its own.
`RECORD TIMELINE` is a read-only query that reports the radio stream timeline and the
start alignment of the current or last recording since boot:

```text
OK RECORD TIMELINE NONE epoch=1 now=123456789
OK RECORD TIMELINE file=REC076.WAV epoch=1 origin=123456789 mic-start=123456789 p=21 skip=533 c=0 tx-rx-phase=731 now=124000000
```

Positions are radio frames since the radio stream started in this `epoch`, which
restarts at boot. `mic-start` is the radio frame in progress when the microphone DMA
started and `origin` is that frame plus `c`, the first frame of the recording on both
tracks. `p` is `mic-start`'s offset into its 512-frame DMA half and `skip` the number
of radio frames dropped from the first half delivered after the start. `tx-rx-phase`
is the SAI2 radio receive DMA index minus the SAI1 monitor transmit index, in frames
modulo the 1024-frame buffer, or `none` without a running monitor; the loopback
qualification uses it to compare boots. `now` is the current position.

`RECORD STOP` requests a clean stop after the next matched radio/mic block.
SD maintenance and stress commands, WAV transfer, and radio band/tuning changes are
rejected while recording is active. `SD STATUS` remains nonintrusive: while the
recorder owns the volume it reports card presence, owner, active file and written
frames and cached free/reserve MiB from recorder state rather than mounting or
querying the filesystem.

## WAV transfer (protocol v1)

`WAV FETCH <path>` emits a versioned binary stream intended for the bench client
rather than a text terminal. Each data frame requires an offset acknowledgement, has
its own CRC32, and contributes to a final whole-file CRC32. The target accepts a root
`REC###.WAV` or a session file, `FIELD/Fnnnn/` followed by `AUDIOnnn.WAV`,
`MANIFEST.TXT` or `EVENTS.BIN` (decision 0030 item 18). A WAV must hold at least its
44-byte header, and other files at least one byte. It rejects transfer during
recording, limits files to 256 MiB (about 15.5 minutes of audio), and closes
the file after ten seconds without an acknowledgement. `WAV ABORT` closes an active
transfer explicitly. No other CLI command may be issued during the binary exchange.
The host side is described in the
[WAV inspection procedure](../procedures/spooky-bench-wav-inspection.md).

## SD card

The SD commands initialize the audio-shield card slot only when requested.
Recorder, SD stress/status, and WAV transfer operations serialize through one
exclusive storage owner lease. A busy client is rejected without stopping or
unmounting the current owner.
`SD STATUS` mounts the volume and reports the card type, capacity, free space,
logical block count, bus width, and active clock divider. `SD REINIT` unmounts,
deinitializes, and mounts it again. The configuration uses four-bit mode, hardware
flow control, and `ClockDiv=2` (75 MHz / 4 = 18.75 MHz) for mounting and transfers.
The card is never switched to high speed, so the bus stays within the 25 MHz
default-speed limit. `ClockDiv=0` bypasses the divider and runs the bus at 75 MHz;
a 2 GB SDSC card fails data CRC there.

Card initialization is bounded. The SD power-up handshake (ACMD41) is tried at most
2000 times, about 1.2 s, slightly more than the SD 1 s power-up allowance. After that,
the card must reach the transfer state within 1 s. A card that fails either step fails
the mount in about 1.2 s instead of blocking the foreground for about 38 s. The working
cards tested mount within about 300 ms. A failed mount, `SD INFO`, `SD FORMAT` or
`RECORD START` reports the failing step, preserved before the handle is deinitialized:

```text
ERR SD mount failed result=FR_NOT_READY(3) stage=HAL_INIT hal=0x01000000 state=0 init_ms=1156 ready_ms=0
```

`stage` is `HAL_INIT` (identification or power-up failed; `hal=0x01000000` is the HAL's
invalid-voltage-range error, a card that never finished powering up), `NOT_READY` (it
never reached the transfer state; `state` is the last card state), `NO_CARD` or `OK`
(the card initialized and the failure is the filesystem itself, such as
`FR_NO_FILESYSTEM`).
`SD STRESS [size-MiB] [passes]` defaults to a 64 MiB, one-pass test. Each pass
overwrites `SDTEST.BIN` with a changing pseudorandom pattern in 16 KiB chunks,
syncs it to the card, reads the whole file back, and compares every byte. A
successful run deletes the test file and reports elapsed time and aggregate
read-plus-write throughput, exact written/verified byte counts, and maximum
individual write/read call times:

```text
SD STRESS 256 4
OK SD STRESS START size=256MiB passes=4 file=SDTEST.BIN chunk=16384; do not remove card
...
OK SD STRESS PASS size=256MiB passes=4 written=1073741824 verified=1073741824 ... file-removed=1
```

The test advances by one 16 KiB filesystem call from `SdTest_Service()` on each
foreground iteration; USB,
IPC, audio, sensor, and control services continue between chunks. `SD STRESS STOP`
closes and removes an in-progress scratch file and reports the bytes written and
verified before cancellation. Recording start and WAV transfer are rejected while the
test owns the card. If a transfer, verification, or cleanup step fails, `SDTEST.BIN`
is retained for inspection and the next stress command refuses to overwrite it.
`SD CLEAN` removes only that fixed test file.

`SD INFO` reads the card's identity and ratings without mounting a filesystem, so it
also works on a card with no readable volume. It reports the card type, whether the
recorder supports it (decision 0014: SDHC/SDXC only), capacity, the CID fields
(manufacturer ID, OEM ID, product name and revision, serial number, manufacturing
date) and the SD Status ratings (speed class, UHS speed grade, video speed class,
allocation unit). Ratings are recorded as evidence; they do not bound write stalls.
Command policy rejects it while recording.

```text
OK SD INFO TYPE=SDHC/SDXC SUPPORTED=1 CAPACITY=15193MiB MID=0x03 OID=SD PNM=SC16G PRV=8.0 PSN=0x934591FE MDT=2022-09 SPEED_CLASS=10 UHS_GRADE=0 VIDEO_CLASS=0 AU=4096KiB
```

`RECORD START` refuses an unsupported card before creating a file:
`ERR RECORD unsupported card TYPE=SDSC; SDHC/SDXC required`. Reading, transfer and
maintenance commands still work on such a card.

`SD FORMAT` provides an optional in-device format; cards formatted elsewhere remain
usable. It is two-step: `SD FORMAT` arms it, and `SD FORMAT CONFIRM` within 10 s
erases every file on the card. A confirm that is unarmed or late is refused, and
consumes the arm. Command policy rejects both while recording or finalizing. The
storage service formats under its own exclusive owner (`FORMAT`) and does not need
a readable filesystem, so a card with a damaged or foreign layout can be
formatted. Only SDHC/SDXC cards are formatted; SDSC is refused before anything is
written.

The layout is one FAT32 volume with 32 KiB clusters and a single FAT. FatFs R0.12c
places the partition at sector 63, and aligns the data area to the card's
allocation unit read from its SD Status register (`ALIGN_SECTORS`; 1 when the card
reports none). The service then mounts the new volume once to verify it. The format
blocks the foreground for its whole duration, about 2 s for a 16 GB card, and runs
only from idle maintenance:

```text
SD FORMAT
OK SD FORMAT armed; erases every file on the card. Send SD FORMAT CONFIRM within 10 s
SD FORMAT CONFIRM
OK SD FORMAT started
OK SD FORMAT FAT32 CLUSTER=32768 ALIGN_SECTORS=8192 SECTORS=31116288 FREE=15189MiB MS=1998
```

Failures report `ERR SD FORMAT unsupported card TYPE=SDSC; SDHC/SDXC required` or
`ERR SD FORMAT failed result=<FRESULT>(<n>) hal=0x<error> MS=<n>`.

## Battery and charge status

`BATTERY READ` (also `BATTERY` or `BATTERY STATUS`) and `CHARGE STATUS` report the
BQ27441 fuel gauge. Outside recording each request reads the gauge, which takes a few
milliseconds of I2C. While recording, fuel-gauge I2C pauses
([foreground latency](foreground-latency.md)) and the reply carries the last
successful reading. `AGE_S` is that reading's age in seconds:

```text
OK BATTERY PRESENT=1 SOC=..% VOLTAGE=.. mV REMAINING=.. mAh FULL=.. mAh DESIGN=.. mAh SOH=..% FLAGS=0x.... AGE_S=0
OK CHARGE VBUS=1 STATE=CHARGING|DISCHARGING|IDLE CURRENT=.. mA POWER=.. mW FULL=0|1 AGE_S=0
```

`STATE` comes from the gauge's average current: above 5 mA is charging, below -5 mA
discharging. The average lags a charger change by a few seconds.

## Low-power charging monitor

`SLEEP START` is a one-way low-power state entered from the CLI; it is rejected in IPC
experiment builds and while the Session state is Preparing, Recording or Finalizing. An active
session receives `ERR SLEEP unavailable while recording` and is unchanged. On entry,
firmware prints one fuel-gauge update, mutes and stops
the audio DMA, powers down and resets the radio, stops USB CDC/HSI48, makes
externally-facing push-pull audio clocks high impedance, and pulls the 3.3 V
regulator enable low. CM4 is held in WFI. CM7 then uses hardware SLEEP with SysTick
suspended. The LSE-backed RTC wake timer performs one 10-second self-test wake and
then wakes every five minutes; firmware briefly enables `3V3_VSYS` to restore the
gauge's I2C pull-ups, prints one charging update on UART7, disables the rail, and
sleeps again. The blue USER button or RESET returns to the normal image through a
system reset. UART output begins with:

```text
[sleep] preparing low-power charging monitor
[fuel] update: ...
[sleep] USB CDC stopped; AUX UART7 remains active
[sleep] RTC wake self-test in 10 seconds, then reports every 5 minutes
[sleep] 3V3_VSYS disabled; CM7 entering SLEEP mode
[sleep] wake report=1 wakes=1 last-drain=ok log-errors=0 log-dropped=0
[sleep] RTC wake self-test passed; five-minute cadence armed
[fuel] update: ...
```

Each RTC report begins with a `wake` line. `wakes` counts every return from WFI since
sleep entry, so it should equal `report` unless another interrupt woke the core;
`last-drain` says whether the UART7 logger emptied before the previous sleep entry
(`aborted` means its remaining bytes were discarded and are counted in
`log-dropped`).

## Fuel-gauge reporting

At boot, firmware prints detailed gauge identification, configuration, and telemetry
on UART7. Runtime output is one compact battery update every five minutes containing
voltage, temperature, average current and power, state of charge, and
remaining/full capacity. Positive current is charging and negative current is
discharging. After USB has enumerated, host suspend/resume is quiet. Until the
gauge's configuration succeeds and it has learned the cell, SOC, SOH, and mAh values
are preliminary.

## Startup console

On reset, UART7 begins with:

```text
[uart] Spooky Probe console on UART7: PE8 TX, PE7 RX, 115200 8N1
```

Successful USB enumeration prints `[usb] PASS: host configured Spooky Box USB CDC CLI`.
A complete audio start ends with one of:

```text
[summary] PASS: radio audio is routed to the headphone codec
[summary] FAIL: radio/audio stream did not start; hardware quiesced
```

## Client notes

This line protocol is also the simplest Pure Data control path. Install the
`comport` serial external using Pd's **Help > Find externals**, open the Spooky
Box COM port, and send the ASCII bytes for `TUNE <kHz>` followed by byte 10. A Pd
slider can map 0..1 to 87500..108000, round the result, prepend `TUNE`, and append
the newline. USB MIDI or OSC can be added later if their ecosystem advantages
outweigh the extra USB-class or network framing work.
