dwight9339/spooky_box_proto/docs/design/repository-layout.md

# Repository and generated-file policy

This project began as an STM32CubeMX dual-core export and now contains both
generated scaffolding and hand-maintained prototype firmware. This document
defines the boundary so a tool regeneration or cleanup does not discard
working behavior.

## Canonical build

Configure and build from the repository root:

```text
cmake --preset Debug
cmake --build --preset Debug
```

Debug and Release are isolated beneath their root preset directories:

```text
build/<Preset>/firmware/CM4/
build/<Preset>/firmware/CM7/
```

Each core directory contains its ELF, map, object files, and
`compile_commands.json`. The root build uses the maintained
`cmake/dual_core_firmware.cmake`; it deliberately does not use CubeMX's root
`mx-generated.cmake`, which puts different configurations into the same
`CM4/build` and `CM7/build` directories.

The opt-in `IpcSmoke` and `IpcMismatch` presets use the same isolated layout.
They enable a diagnostic workload on M4 and reserve the same shared mailbox
in both images; neither changes the default PlatformIO environment. See
[IPC smoke test](../procedures/ipc-smoke-test.md) before deploying either pair.

The per-core presets under `CM4/` and `CM7/` remain useful for isolated
experiments, but the root preset is the canonical dual-core build and the one
used by `platformio/deploy.py`.

## File ownership

| Path | Ownership | Policy |
| --- | --- | --- |
| `full_spooky_proto.ioc` | CubeMX project input | Track it. It is not yet authoritative for every proven runtime setting; consult the [CubeMX reconciliation register](cubemx-reconciliation.md) before regeneration. |
| `.mxproject`, `.settings/`, `CM4/.settings/`, `CM7/.settings/` | STM32Cube metadata | Track them while STM32Cube tooling is part of the workflow. |
| `CM4/Core/`, `CM7/Core/`, `CM7/USB_Device/` | Mixed generated scaffolding and hand-maintained code | Track them. Do not overwrite them through CubeMX until the documented `.ioc` discrepancies are reconciled and the diff is reviewed. |
| `CM4/mx-generated.cmake`, `CM7/mx-generated.cmake` | CubeMX-generated core source lists | Track them; regeneration may update them. Review changes before accepting. |
| `mx-generated.cmake` | CubeMX-generated root orchestration | Track as tool output/reference, but the canonical build does not include it. |
| Root and per-core `CMakeLists.txt`, `gcc-arm-none-eabi.cmake` | Generated once, then maintained | Track and edit deliberately. CubeMX documents the CMake project files as one-time generated files. |
| `cmake/`, `platformio/`, `docs/`, `CM7/App/`, `tests/`, IPC/log/diagnostic and audio-timeline modules in `Common/` | Hand-maintained | Track and review normally; source lists belong in maintained core CMake files. |
| `docs/design/behavior/<Name>Sm.puml` | Behavior-model source ([decision 0006](../decisions/0006-statesmith-behavior-model.md)) | Track and edit by hand. Each diagram is the single source of one M7 state machine. |
| `CM7/App/sm/<Name>Sm.c`, `CM7/App/sm/<Name>Sm.h` | Generated by StateSmith from the diagram | Track them and never edit them by hand; regenerate (below). The hand-written port files in the same folder (`<region>_port.h`, `.c`) and the types they share, such as `gesture.h`, are maintained normally. |
| `docs/design/behavior/<Name>Sm.svg` | Rendered by PlantUML from the diagram | Track them and never edit them by hand; regenerate (below). |
| `.config/dotnet-tools.json` | Pinned StateSmith CLI version | Track; change the version deliberately and regenerate every machine in the same change. |
| Both core linker scripts | Generated originally, now maintained | Preserve the identical SRAM4 IPC reservation/NOLOAD section and M7 DMA placement during regeneration. |
| `Drivers/`, `Middlewares/` | Vendored STM32 dependencies | Track to keep the build reproducible; update as an intentional SDK change. |
| `build/`, `.pio/`, `*.su`, CubeMX PDF/TXT reports | Generated output | Ignore; regenerate locally as needed. |
| `.vscode/settings.json`, `.vscode/extensions.json` | Shared editor policy | Track only portable settings. |
| `.vscode/c_cpp_properties.json`, `.vscode/launch.json` | Tool-generated machine state | Ignore because the generated versions contain local paths. |

## Local changes to vendored code

Vendored STM32 code is unmodified except for the changes listed here. Re-apply each
one, or replace it deliberately, whenever `Drivers/` or `Middlewares/` is updated.

| File | Change | Reason |
| --- | --- | --- |
| `Drivers/STM32H7xx_HAL_Driver/Inc/stm32h7xx_ll_sdmmc.h` | `SDMMC_MAX_VOLT_TRIAL` wrapped in `#ifndef`; the HAL default is unchanged | `CM7/CMakeLists.txt` sets it to 2000 for both the application and the generated `STM32_Drivers` library, so a card that never completes power-up fails in about 1.2 s instead of about 38 s (`jjy.15`) |

## Regeneration rule

STM32CubeMX generation is currently frozen. The `.ioc` is an inventory and pin-map aid,
not an authoritative source, because blocking runtime and ownership discrepancies remain
and CubeMX 6.17 does not complete a scratch generation of this dual-core project. See the
[CubeMX reconciliation register](cubemx-reconciliation.md).

Any future evaluation must follow the
[scratch-generation and diff procedure](../procedures/cubemx-scratch-generation.md).
Start from a clean, preserved tree; generate only in isolated scratch space; inspect the
complete generated-surface diff; restore every proven runtime override CubeMX cannot
express; and pass all build and bench gates before adopting output. Never recursively
copy a CubeMX export over the repository.

Board diagnostics, prototype-power policy, and the M7 storage-volume ownership
service live in `CM7/App`. The UI input and rendering policy also live there behind
fixed-bound APIs, while `Core/Src/ui_board_test.c` remains the current M7-only
hardware/diagnostic adapter for the proven pin map. Hardware initialization and IRQ
wrappers remain in generated shells. The recorder, SD diagnostics, and WAV transfer clients keep
their own `FIL` objects but never mount, unmount, or reconfigure the shared
volume directly.
Portable IPC tests build independently through `tests/CMakeLists.txt` and never
inherit the firmware cross toolchain.

Longer term, more hand-maintained application code should move into `CM7/App`,
`CM4/App`, and core-neutral `Common` modules. That reduces the amount of
working behavior living inside generated shells without requiring a risky
one-time repository rewrite.

## Behavior-model regeneration

`host/tools/behavior_model.py` regenerates every state machine and diagram from
`docs/design/behavior/*Sm.puml`. `--check` fails, without writing anything, when a
committed generated file differs from what the diagrams produce, when one is missing,
or when one is stale because its diagram was deleted. Run the check before committing
a behavior-model change.

```text
python host/tools/behavior_model.py
python host/tools/behavior_model.py --check
```

The script needs the .NET 8 SDK or later, found through `DOTNET_ROOT` or `PATH`. It
restores the pinned StateSmith CLI with `dotnet tool restore`. Rendering needs a Java
runtime (tested with Java 21), found through `JAVA_HOME` or `PATH`. The pinned PlantUML jar is downloaded
once into `build/tools/` and verified by SHA-256. PlantUML uses the `smetana` layout,
so Graphviz is not needed. The firmware and host-test builds run neither tool, because
generated files are committed.

Generated C is compared byte for byte; StateSmith produces the same C on Windows and
Linux. SVG layout depends on the fonts Java finds on each platform, so each SVG begins
with a stamp comment recording the SHA-256 of its diagram, the PlantUML version and
the SHA-256 of the rendered body. The check compares the stamp with the current
diagram and with the file itself; it needs no Java and passes whichever platform
rendered the file. Regeneration re-renders an SVG only when its stamp is out of date.

Host tests add generated machines with `spooky_generated_sm()` in
`tests/CMakeLists.txt`. It suppresses two warnings for those files only: unused
parameters, because some generated handlers ignore their `sm` argument, and MSVC's
unreachable-code warning, because StateSmith emits an ancestor check after a
transition's `return`.
