dwight9339/spooky_box_proto/docs/design/behavior/top-level.md

# Top-level chart

The whole device as one composite state with parallel regions, plus the low-power
state that leaves it. Conventions are in the [model README](README.md). Prefix:
`DEV` for device-level rows.

Constitution: Principle I (navigation never interrupts a session), Principle III
(single authority, release-all on input loss), Principle VII (Field and Instrument as
the two operating modes; utilities return to the previous context).

## Diagram

```mermaid
stateDiagram-v2
    [*] --> Device
    state Device {
        state Context {
            [*] --> Operating
            Operating : Field or Instrument pages and menus
            Operating --> Utility : Shift plus Encoder 0
            Utility --> Operating : Encoder 3 hold or back at the root, restore H*
        }
        --
        state Session {
            [*] --> Idle
            Idle --> Active : StartSession
            Active --> Idle : completed or aborted
        }
        --
        state Radio {
            [*] --> Settled
            Settled --> Tuning
            Tuning --> Settled
            Settled --> BandTransition
            BandTransition --> Settled
            BandTransition --> Faulted
            Settled --> Faulted
        }
        --
        state InputResolution {
            [*] --> Neutral
            Shift : Ready, button pending, spent
            Btn0Held : Pending, prompt, consumed
            Neutral --> Shift
            Shift --> Neutral
            Neutral --> Btn0Held
            Btn0Held --> Neutral
        }
    }
    Device --> LowPower : DEV-01 EnterSleep
```

`H*` marks deep history: closing a utility restores the operating page that opened it.
Every region is summarized here; their machines are in [ContextSm.puml](ContextSm.puml),
[SessionSm.puml](SessionSm.puml), [RadioSm.puml](RadioSm.puml) and
[InputResolutionSm.puml](InputResolutionSm.puml). InputResolution resolves inputs into
gestures, and Context decides what a gesture means where the controls are
([decision 0009](../../decisions/0009-first-slice-field-controls.md)).

## Regions

A region exists only where its state changes which transitions are legal or how
commands and inputs are interpreted.

| Region | Question it answers | Why it is a region | Detail |
|---|---|---|---|
| Context | Which operating mode, engine page, menu or utility has the controls | It decides what a resolved gesture means | [ContextSm.puml](ContextSm.puml), first Field slice: Classic, Manual, the engine and band menus, and the utility root |
| Session | Whether a recording lifecycle is active | Active sessions reject SD maintenance and WAV transfer, and change how stop and faults are handled | [SessionSm.puml](SessionSm.puml) |
| Radio | Whether a band or tuning transition is in progress | Commands arriving mid-transition need defined handling | [RadioSm.puml](RadioSm.puml) |
| InputResolution | How held controls, Shift and chords are being interpreted | The same press means different things while Shift is held or a chord is pending | [InputResolutionSm.puml](InputResolutionSm.puml): clicks, holds, the Shift layer, the Button 0 and 1 chord group and the Button 0 session hold |

Shift is part of InputResolution, not a peer of Session or Context: it changes how
inputs resolve into commands, not what the product is doing.

Field engines, Instrument engines and performance views are substates of Operating.
[ContextSm.puml](ContextSm.puml) models the first-slice Field engines, Classic and
Manual; the full list is in the product
[mode hierarchy](../../../spec/product/modes-and-interaction.md#mode-hierarchy).

## States

| ID | State | Meaning |
|---|---|---|
| DEV-S1 | Device | The normal application is running |
| DEV-S2 | LowPower | The charging monitor: audio, radio and USB are stopped, and the M7 wakes only to report the fuel gauge |

## Invariants

| ID | While | Invariant |
|---|---|---|
| DEV-I1 | Device | No Context transition stops, replaces or invalidates an active session. Session state is unchanged by every transition of [ContextSm.puml](ContextSm.puml). |
| DEV-I2 | Device | A restart, overflow or staleness in input reporting releases every held control before later input events are interpreted, so no control such as Shift or PTT stays latched. |
| DEV-I3 | `in(Session.Active)` | SD maintenance and WAV transfer commands do not execute; they are rejected with a reason. |
| DEV-I4 | Device | Session state never makes a radio command illegal. Tune, tune-step and band commands are handled the same in every Session state. |
| DEV-I5 | `in(Session.Active)` | The radio track keeps its timeline through receiver transitions. Each radio half-buffer held back during a transition is written as digital silence of the same length, and the gap's start and end are published with their sample positions. |

## Guards

| Guard | Evaluated | Holds when |
|---|---|---|
| sleep_supported | Before actions | The image is not an IPC experiment build: IpcSmoke or IpcMismatch |

## Transitions

| ID | From | Trigger | Guard | Actions | To | Publishes |
|---|---|---|---|---|---|---|
| DEV-01 | Device | EnterSleep | `in(Session.Idle)` and sleep_supported | Report the fuel gauge; stop any SD test; stop audio, radio and USB | LowPower | SleepEntered |
| DEV-02 | Device | EnterSleep | not sleep_supported | None | Device | SleepRejected |
| DEV-03 | Device | EnterSleep | `in(Session.Active)` | Reject without changing the session; record `COMMAND_REJECTED` | Device | SleepRejected |

LowPower is left only by a system reset, from the USER button or RESET, which
restarts the model at its initial state.

## Maturity

| ID | Status | Basis |
|---|---|---|
| DEV-I1 | Target | Constitution Principle I |
| DEV-I2 | Target | Constitution Principle III |
| DEV-I3 | Target | Implemented; no bench evidence |
| DEV-I4 | Target | Product intent: [roadmap](../../../spec/product/roadmap.md) M3 scope, in-band tuning and band transitions while recording; [Modes and interaction](../../../spec/product/modes-and-interaction.md#field-sessions), Field Sessions; [decision 0003](../../decisions/0003-radio-control-during-recording.md) |
| DEV-I5 | Target | [Decision 0004](../../decisions/0004-radio-track-continuity-across-transitions.md); [Modes and interaction](../../../spec/product/modes-and-interaction.md#field-sessions), Field Sessions |
| DEV-01 | Proven | Sleep entry while idle: [radio regression](../../evidence/2026-09-24-radio-regression.md) |
| DEV-02 | Target | Implemented in the IPC experiment builds; no bench evidence |
| DEV-03 | Target | Implemented and host tested under [decision 0008](../../decisions/0008-recording-safe-command-policy.md); no bench evidence |

## Deviations

| Row | Firmware today | Tracked by |
|---|---|---|
| DEV-I4 | Band changes are rejected while a session is active with `ERR RADIO band changes disabled while recording`. Principle VI keeps this guard until bench qualification passes. In-band tuning (tune, `UP`, `DOWN`, Classic) is allowed in every session state since the [tune guard lift](../../evidence/2026-10-16-tune-guard-lift.md) (`full_spooky_proto-54w.6`). | `full_spooky_proto-54w.12` |
| DEV-I5 | The band-switch stream gate drops radio half-buffers instead of passing silence. Unreachable during a session today, because the DEV-I4 guard rejects band changes while recording. | `full_spooky_proto-54w.12` |
| Session domain events | The authoritative machine publishes semantic events to the recorder/CLI adapter; outbound presentation IPC is not wired yet. | `full_spooky_proto-54w.4` |
