dwight9339/spooky_box_proto/docs/evidence/2026-10-01-sd-format.md

# In-device SD format

Date: 2026-10-01 (local time; the UTC timestamps in the log and run IDs read 2026-10-02)
Beads issue: `full_spooky_proto-jjy.14`

This session checks the optional `SD FORMAT` / `SD FORMAT CONFIRM` command on four
cards: a reference card for the confirmation guards, an unresponsive card, a used
SDHC card that is formatted and then recorded on, and an SDSC card that must be
refused.

## Setup and provenance

| Item | Value |
| --- | --- |
| Source revision | `adb1756` plus the jjy.14 change (`CM7/App/sd_media.[ch]`, `CM7/App/storage_service.[ch]`, `CM7/App/storage_lease.[ch]`, `CM7/Core/Src/sd_diskio.c`, `CM7/Core/Src/sd_test.c`, `CM7/Core/Inc/ffconf.h`, `CM7/App/diagnostics.c`, `CM7/CMakeLists.txt`, `tests/`) |
| Bench image | `build/bench-jjy14-format-20261001a.json`, build ID `jjy14-format-20261001a`, Debug preset; patch `build/jjy14-format-20261001a.patch` |
| Committed source | Differs from the bench patch only in docs |
| Flash | Spooky Bench `flash`, pass, both cores verified (run `2026-10-02T022410.446750_0000-c2347b86`). An earlier attempt (`2026-10-02T022219.350235_0000-7c973de6`) failed with `cannot read IDR` while the SWD cable was disconnected; nothing was written. `DIAG IDENTITY` reported `BUILD=jjy14-format-20261001a` |
| FatFs | R0.12c from STM32CubeH7 V1.13.0, `_USE_MKFS=1`, `_FS_EXFAT=0` |
| Board | Nucleo prototype; target CDC `335A34763533`; probe `E66540F0A345382D` |
| Driver | `build/sd_failure_jjy4.py`; all CDC lines in `build/jjy14-session.jsonl` |
| Bench power, listening check, WAV inspection | Not performed |

## Cards

| Card | Notes |
| --- | --- |
| 64 GB SDHC/SDXC reference card | Holds earlier evidence recordings; only the non-destructive guards were run on it |
| 8 GB SDHC | Does not mount in Windows; condition unknown |
| 16 GB SDHC | Used Raspberry Pi system card (boot FAT32 partition plus a Linux partition); its prior contents were disposable |
| 2 GB SDSC | Same block count as the jjy.4 test card (3,862,528 blocks) |

## Results

### Confirmation guards (64 GB reference card)

- `SD FORMAT CONFIRM` without `SD FORMAT`: `ERR SD FORMAT not armed or expired`.
- `SD FORMAT`, then `SD FORMAT CONFIRM` 11.5 s later: same refusal.
- `SD STATUS` afterwards: `FREE=57576MiB`, unchanged.

### Unresponsive card (8 GB SDHC)

`SD STATUS` failed twice with `ERR SD mount failed result=FR_NOT_READY(3)
hal=0x00000000`, each after about 30 s. `SD FORMAT CONFIRM` failed the same way:
`ERR SD FORMAT failed result=FR_NOT_READY(3) hal=0x00000000 MS=37788`. The card
never reached the transfer state, so the format wrote nothing. This matches Windows,
which also cannot mount it, and the card is recorded as unusable.

Each attempt blocked the foreground for the driver's 30 s ready timeout
(`LOOP_MAX_MS=37804`). This is existing driver behavior, filed as `jjy.15`.

### Format and record (16 GB SDHC)

| Step | Result |
| --- | --- |
| `SD STATUS` before | `TYPE=SDHC/SDXC CAPACITY=15193MiB FREE=435MiB`: the Pi boot partition only |
| `SD FORMAT` + `SD FORMAT CONFIRM` | `OK SD FORMAT FAT32 CLUSTER=32768 ALIGN_SECTORS=8192 SECTORS=31116288 FREE=15189MiB MS=1998` |
| `SD STATUS` after | `FREE=15189MiB`, the whole card |
| 60 s recording (`REC000.WAV`) | `OK RECORD PASS`, exact frames, queues 1/8, max write 46 ms, histogram `0,644,57,2,1,0,0,0`, `HAS_FAULT=0`; `RECORD RESULT` matched |
| `SD STRESS 64 1` | Pass, 64 MiB written and verified, write max 58 ms, read max 10 ms, 0.5 MiB/s aggregate |
| 60 s recording immediately after (`REC001.WAV`) | `OK RECORD PASS`, queues 1/8, max write 66 ms, histogram `0,558,142,1,2,0,1,0`, `HAS_FAULT=0` |

`ALIGN_SECTORS=8192` is a 4 MiB allocation unit reported by the card. The jjy.4
SDSC card took 780-810 ms for its first write after an interrupted stress run; here
the first recording after a completed stress run peaked at 66 ms. The conditions are
not identical, and this is one used card: survey data for `jjy.8`, not a media
contract.

### SDSC refusal (2 GB SDSC)

| Step | Result |
| --- | --- |
| `SD STATUS` before | `TYPE=SDSC CAPACITY=1886MiB FREE=1807MiB` |
| `SD FORMAT` + `SD FORMAT CONFIRM` | `ERR SD FORMAT unsupported card TYPE=SDSC; SDHC/SDXC required`, immediately |
| `SD STATUS` after | `FREE=1807MiB`, mounts as before |

## Verdict

Pass: the format is guarded by a single-use 10 s confirmation, refuses SDSC and
unresponsive cards without writing, and produces an erase-block-aligned FAT32
volume that mounts and records cleanly. Only one card was formatted successfully;
broader media evidence belongs to the `jjy.8` survey.
