dwight9339/spooky_box_proto/tests/README.md

# Host tests

Run in a shell with a native C11 compiler, CMake, and Ninja on PATH. On
Windows use a Visual Studio Developer Command Prompt (VS 2019 16.11 or newer).
These tests do not use the ARM toolchain or connect to the board.

The separate Python Spooky Bench tests live in `host/tests`; see
[bench setup](../docs/procedures/spooky-bench-setup.md#simulation-and-tests). They do not
change or replace these native firmware tests.

```text
cmake -S tests -B build/host -G Ninja -DCMAKE_BUILD_TYPE=Release
cmake --build build/host
ctest --test-dir build/host --output-on-failure
```

Tests report failures with an always-on `CHECK` macro. `tests/CMakeLists.txt` also
removes `NDEBUG` from every build type's flags, so an `assert()` in a test or stub still
checks in this Release build.

Tests of StateSmith machines add the generated C from `CM7/App/sm` with
`spooky_generated_sm(<test> <Name>Sm.c)`. It suppresses unused-parameter warnings, and
MSVC's unreachable-code warning, for those files only.

The InputResolution tests drive the generated machine through its real port against a
fake integration that records deliveries, commands, published events and timer calls.
They cover each behavior of decision 0005 items 1-9: the start and stop prompts,
swallowing before the prompt, confirm, cancel, dismissal, the swallowed rest of the
hold, withdrawal on a session change, pre-held releases delivered exactly once, and
release-all from every state. A seeded random sequence checks that every input gets
exactly one outcome and that only a confirming Encoder 0 press issues a command.

The Session tests drive the generated Session machine through its port with scripted
action results: start success, each rejection and abort path, stop and repeated stop,
block-driven completion, failed finalization and capture faults, plus a seeded random
check that a failure is never published as a success. The Session authority tests post
external commands and internal recorder outcomes through the real event queue and
dispatcher, verify that machine actions invoke the recorder in order, and check that
an unreported recorder change still produces a disagreement diagnostic.

The Radio tests drive the generated Radio machine through its port against a fake
radio service: start outcomes, range rejection, a tune that waits for completion,
issue and completion failures, latest-wins replacement of a waiting command with a
superseded answer, a band switch waiting behind a tune, band-switch and audio
faults abandoning work in progress, band-edge stop and wrap, stale completions, and
a seeded random check that every command is answered exactly once. The radio
control tests run the real radio control service against a fake Si4735 on a fake
I2C bus and tick. They check that a tune returns before it completes, that each
poll is at most one status transaction and respects the poll interval, that a tune
fails at the 2 s device timeout, that a stuck receiver fails a poll or an issue
within the provisional 5 ms device-ready bound, and that the published result
changes only when a tune completes. The fake is not a model of Si4735 timing.

The command-policy tests cover every decision-0008 action in Idle, Recording and
Finalizing, verify that no action is deferred, require one stable acknowledgement for
every rejection, and check the current CLI-to-action mappings. These are portable
policy tests, not recording evidence.

The storage-lease test checks exclusive ownership across recorder, SD stress,
WAV transfer and status clients, including busy acquisition and invalid-release
counters. Media mounting and SDMMC behavior remain hardware-only evidence.

The reply-queue test checks the recorder's USB reply policy: with the port closed for
a whole recording, progress lines coalesce to the newest one and the outcome and
diagnostic replies survive in order; a full queue evicts progress before replies, then
the oldest reply, and counts both. USB CDC timing remains hardware-only evidence.

The recording-result test checks the `RECORD RESULT` record: `NONE` before the first
recording, PASS only when not aborted and finalized, the sequence (which skips 0 on
wrap), truncated file and reason strings, and that the longest reply fits the
recorder's 240-byte reply line.

The SD-media test checks the in-device format helpers: the FatFs data-area alignment
derived from every SD Status allocation-unit code (a power of two of at most 16 MiB,
1 when undefined) and the `SD FORMAT` arm/confirm window, including expiry, single
use and tick wrap. It also checks the decision 0014 media helpers: only SDHC/SDXC is
supported, card-type names, speed-class and allocation-unit decoding, and the
`SD INFO` line, including '?' for unprintable identity bytes and worst-case field
widths. Formatting and card reads remain hardware-only evidence.

The storage-margin test checks the decision 0014 warning: the queue high-water and
single-write thresholds (each inclusive), latching with the first values kept, a
single first-crossing edge, and reset between recordings.

The event-queue tests cover decision 0007: post order, sequence and time, admission
by class with the internal reserve, reject-newest overrun, one reconcile event after
rejected input, bounded run-to-completion dispatch, the reserve's exact limit when
handled events post internal events, tick and sequence wrap, and counters. The
logger/diagnostic tests also check the `DIAG QUEUE` line and the `EVENT_QUEUE_LOSS`
fault.

The audio-timeline tests cover the portable arithmetic of decision 0012: 32-bit
counter extension across wrap, DMA snapshots taken while a half-buffer completion is
pending but not yet counted, a monotonic walk across many buffers, stream restart
epochs and stale positions, backwards counts, start alignment of the radio and
microphone tracks against a modelled common signal, the number of radio frames the
recorder drops from the next delivered half with and without a completion pending at
the snapshot, and event-stamp uncertainty clipped at an origin. The firmware links
this module for the recorder start, but these tests say nothing about DMA timing, the
DFSDM start latency or recording alignment on the board; those need the decision 0012
item 9 loopback qualification.

The matrix-feedback tests cover decision 0013. The EMF-level tests check each bucket
boundary, unknown states for no sample, no baseline, a stale sample (more than
500 ms old, across tick wrap) and a sensor fault, and recovery on the next sample. The
radio-activity tests check that steady sound never fires however loud, onset sizes
for doubled, tripled, quadrupled and eightfold steps, a short burst reported at its
peak, re-arming only below 1.25x, held averages and a dropped pending onset while the
radio is not measuring, reseeding after reset, and the near-silence floor. The
renderer tests check the loop geometry with and without the trail, EMF colour latched
at step 0 with unknown shown at once, step dropping under late service, kick shift,
clipping, decay and alternation, the recording border going dark during kicks, and
the three-blink fault border.

The matrix-writer tests (`full_spooky_proto-54w.8`) check every logical pixel against
the per-pixel arithmetic proven on the bench before the writer existed, with the
180-degree mounting rotation applied, that a frame written as row runs leaves the
registers exactly as 81 single-pixel writes would, that only changed runs are
written, that a failed run stays pending, and that a new frame replaces the old one
without writing its stale runs. The matrix-service tests check that nothing is written
until feedback is enabled, that the first frame is written in full and a steady frame
writes nothing, that an onset and the recording border change the frame, that a failed
run is retried, that invalidating or re-enabling rewrites every run while keeping the
session state, and that the trail is off by default and keeps its setting. They are
host results: how the matrix looks and what the writes cost on I2C2 are bench
evidence.

The radio-activity-feed tests drive the onset detector the way the radio capture
callback and the foreground do (`full_spooky_proto-54w.32`). They check that blocks
from the start stamp of a decision 0015 retune interval through one block after the
radio is seen settled are not measured, that a block delivered before the stamp but
drained later still is, that a receiver mute and its end fire no onset while a louder
landing after the interval does, back-to-back tunes, an unreadable stream position,
the radio not running, the 100 ms stale bound, a full ring dropping and counting the
newest block, reseeding after a band switch, and the largest onset kept until taken.
The Classic hold tests (decision 0016 items 16 to 20) feed onset sequences through
the scan core and the Classic service: no hold at hold time zero or below the
trigger size, start, extension by onsets up to the release time, release with the
jump at once and the schedule restarted from it, the hold-time cap, one hold per
landing (including after a failed tune), no hold without a valid measurement or
during a tune, the hold ending when the measurement is lost, Classic cannot move or
the frequency changes elsewhere, pause during a hold, a resume that jumps rather than
holds, a hold-time change mid-hold, the published `HOLDING` state and its count, and
unable to scan replacing it. These are host results: they say nothing about the
detector on real radio audio, the half-buffer timing or where the receiver's mute
actually falls.

The IPC tests compile the same portable protocol code as both cores. They
exercise invalid headers, version/size mismatches, first handshake, missing
acknowledgements, corrupted echoes, stale repeated packets, recovery, sequence
wrap, tick wrap, and independent core clock epochs. Checks remain enabled in
Release. The firmware builds also enforce the packet layout with C11 static
assertions and the mailbox allocation with linker assertions.

The logger/diagnostic tests compile the real App adapters against fake HAL and
USB transports, as well as the portable buffers. They check queue saturation,
buffer lifetime while UART owns a chunk, wrap and refill, context rejection,
transport errors, timeout across tick wrap, bounded sleep drain/abort, event
overwrite, preserved latest fault, and sequence wrap. CLI tests cover USB busy
retry, finite dumps, overwrite gaps, cancellation, timeout, and streamed HELP.
The HAL stub is not a UART timing or NVIC simulator.

These tests do **not** establish SRAM visibility, MPU/cache behavior, HSEM
operation, boot timing, or recording reliability. Those require the
[IPC bench procedure](../docs/procedures/ipc-smoke-test.md).
