dwight9339/spooky_box_proto/CM7/Core/Src/main.c

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
/* Includes ------------------------------------------------------------------*/
#include "main.h"

/* USER CODE BEGIN Includes */

#include <stdbool.h>
#include <stdio.h>
#include <string.h>
#include "app_dispatch.h"
#include "audio_path_service.h"
#include "board_diagnostics.h"
#include "build_identity.h"
#include "classic_adapter.h"
#include "matrix_adapter.h"
#include "codec_volume_service.h"
#include "command_policy.h"
#include "target_logger.h"
#include "diagnostics.h"
#include "foreground_budget.h"
#include "ipc_smoke_cli.h"
#if defined(SPOOKY_LOGGER_LOAD_QUALIFICATION)
#include "logger_load.h"
#endif
#if defined(SPOOKY_ISR_TIMING_QUALIFICATION)
#include "isr_timing.h"
#endif
#if defined(SPOOKY_IPC_SMOKE)
#include "ipc_smoke.h"
#endif
#include "prototype_power.h"
#include "fuel_gauge_test.h"
#include "magnetometer_test.h"
#include "radio_adapter.h"
#include "radio_control_service.h"
#include "radio_recorder.h"
#include "sd_test.h"
#include "storage_service.h"
#include "ui_board_test.h"
#include "usb_test.h"
#include "wav_transfer.h"

/* USER CODE END Includes */

/* USER CODE BEGIN PD */

#define SPOOKY_MINIMAL_BRINGUP

/* DUAL_CORE_BOOT_SYNC_SEQUENCE: Define for dual core boot synchronization    */
/*                             demonstration code based on hardware semaphore */
/* This define is present in both CM7/CM4 projects                            */
/* To comment when developping/debugging on a single core                     */
#define DUAL_CORE_BOOT_SYNC_SEQUENCE

#if defined(DUAL_CORE_BOOT_SYNC_SEQUENCE)
#ifndef HSEM_ID_0
#define HSEM_ID_0 (0U) /* HW semaphore 0*/
#endif
#endif /* DUAL_CORE_BOOT_SYNC_SEQUENCE */

/* USER CODE END PD */

/* USER CODE BEGIN PM */

#define RUN_FOREGROUND(service_id, statement) do { \
  bool foreground_capture_before = RadioRecorder_IsCapturing(); \
  uint32_t foreground_started_ms = HAL_GetTick(); \
  statement; \
  Diagnostics_ObserveForeground((service_id), \
    HAL_GetTick() - foreground_started_ms, \
    foreground_capture_before && RadioRecorder_IsCapturing()); \
} while (0)

/* USER CODE END PM */


COM_InitTypeDef BspCOMInit;
ADC_HandleTypeDef hadc3;

DFSDM_Channel_HandleTypeDef hdfsdm1_channel0;
DFSDM_Filter_HandleTypeDef hdfsdm1_filter0;

I2C_HandleTypeDef hi2c1;
I2C_HandleTypeDef hi2c2;
I2C_HandleTypeDef hi2c4;

SAI_HandleTypeDef hsai_BlockA1;
SAI_HandleTypeDef hsai_BlockB1;
SAI_HandleTypeDef hsai_BlockA2;
DMA_HandleTypeDef hdma_sai1_a;
DMA_HandleTypeDef hdma_sai1_b;

SD_HandleTypeDef hsd1;

SPI_HandleTypeDef hspi6;

void SystemClock_Config(void);
void PeriphCommonClock_Config(void);
static void MX_GPIO_Init(void);
static void MX_DMA_Init(void);
static void MX_I2C1_Init(void);
static void MX_I2C4_Init(void);
static void MX_SAI1_Init(void);
static void MX_SDMMC1_SD_Init(void);
static void MX_ADC3_Init(void);
static void MX_DFSDM1_Init(void);
static void MX_I2C2_Init(void);
static void MX_SAI2_Init(void);
static void MX_SPI6_Init(void);
/* USER CODE BEGIN PFP */

static void Bringup_Run(void);
static void UsbCliCommand(const char *line);
static void RadioAudio_Service(void);

/* USER CODE END PFP */

/* USER CODE BEGIN 0 */

static bool RadioAudioStart(void)
{
  if (!AudioPath_Init(&hsai_BlockA2, &hsai_BlockA1) ||
      !CodecVolume_Init(&hi2c4, &hadc3, &hsai_BlockA1) ||
      !AudioPath_StartCapture() ||
      !RadioControl_Start(&hi2c1) ||
      !AudioPath_StartMonitor())
  {
    goto failed;
  }
  return true;

failed:
  (void)CodecVolume_SetTransitionMuted(true);
  RadioControl_HoldReset();
  return false;
}

static bool RadioParseFrequencyKHz(const char *text, uint32_t *frequency_khz)
{
  uint32_t value = 0U;
  bool have_digit = false;

  if ((text == NULL) || (frequency_khz == NULL))
  {
    return false;
  }
  while ((*text == ' ') || (*text == '\t'))
  {
    ++text;
  }
  while ((*text >= '0') && (*text <= '9'))
  {
    have_digit = true;
    if (value > 1000000U)
    {
      return false;
    }
    value = (value * 10U) + (uint32_t)(*text - '0');
    ++text;
  }
  while ((*text == ' ') || (*text == '\t'))
  {
    ++text;
  }
  if (!have_digit || (*text != '\0'))
  {
    return false;
  }
  *frequency_khz = value;
  return true;
}

static bool RadioParseBand(const char *text, RadioBand *band)
{
  if ((text == NULL) || (band == NULL))
  {
    return false;
  }
  while ((*text == ' ') || (*text == '\t'))
  {
    ++text;
  }
  for (uint32_t index = 0U; index < RADIO_BAND_COUNT; ++index)
  {
    if (strcmp(text, RadioControl_GetBandInfo((RadioBand)index)->name) == 0)
    {
      *band = (RadioBand)index;
      return true;
    }
  }
  return false;
}

static void RadioUsbSendBand(void)
{
  RadioControlStatus status;
  const RadioBandInfo *config;
  char response[128];

  (void)RadioControl_GetStatus(&status);
  config = RadioControl_GetBandInfo(status.band);
  (void)snprintf(response, sizeof(response),
                 "OK RADIO BAND=%s RANGE=%lu..%lu kHz STEP=%lu kHz\r\n",
                 config->name, (unsigned long)config->minimum_khz,
                 (unsigned long)config->maximum_khz,
                 (unsigned long)config->step_khz);
  (void)UsbTest_SendText(response);
}

static void VolumeUsbSendStatus(void)
{
  CodecVolumeStatus status;
  char response[112];
  uint32_t level_percent;

  if (!CodecVolume_GetStatus(&status) || !status.ready)
  {
    (void)UsbTest_SendText("ERR VOLUME pot unavailable\r\n");
    return;
  }
  level_percent = (status.volume_adc * 100U + 32767U) / 65535U;
  if (status.volume_muted)
  {
    (void)snprintf(response, sizeof(response),
                   "OK VOLUME ADC=%lu LEVEL=%lu%% MUTED=1\r\n",
                   (unsigned long)status.volume_adc,
                   (unsigned long)level_percent);
  }
  else
  {
    (void)snprintf(response, sizeof(response),
                   "OK VOLUME ADC=%lu LEVEL=%lu%% ATTEN=-%lu.%lu dB MUTED=0\r\n",
                   (unsigned long)status.volume_adc,
                   (unsigned long)level_percent,
                   (unsigned long)(status.attenuation_half_db / 2U),
                   (unsigned long)((status.attenuation_half_db & 1U) ?
                                   5U : 0U));
  }
  (void)UsbTest_SendText(response);
}

static void UsbCliCommand(const char *line)
{
  char command[64];
  RadioBand target_band;
  CommandAction action;
  CommandPolicyClass policy;
  uint32_t frequency_khz;
  bool posted = false;
  size_t length;

  if (line == NULL)
  {
    return;
  }
  while ((*line == ' ') || (*line == '\t'))
  {
    ++line;
  }
  length = strlen(line);
  while ((length > 0U) &&
         ((line[length - 1U] == ' ') || (line[length - 1U] == '\t')))
  {
    --length;
  }
  if ((length == 0U) || (length >= sizeof(command)))
  {
    (void)UsbTest_SendText("ERR empty or oversized command\r\n");
    return;
  }
  for (size_t index = 0U; index < length; ++index)
  {
    char character = line[index];
    command[index] = ((character >= 'a') && (character <= 'z'))
      ? (char)(character - ('a' - 'A')) : character;
  }
  command[length] = '\0';

  /* A WAV transfer is a framed binary exchange. Do not interleave replies from
   * other command handlers while its host is waiting for a frame. */
  if (WavTransfer_IsActive())
  {
    (void)WavTransfer_HandleCommand(command);
    return;
  }

  if (BuildIdentity_HandleCommand(command))
  {
    return;
  }

#if defined(SPOOKY_LOGGER_LOAD_QUALIFICATION)
  if (LoggerLoad_HandleCommand(command))
  {
    return;
  }
#endif
#if defined(SPOOKY_ISR_TIMING_QUALIFICATION)
  if (IsrTiming_HandleCommand(command))
  {
    return;
  }
#endif
  if (Diagnostics_HandleCommand(command))
  {
    return;
  }
  action = CommandPolicy_ActionFromCli(command);
  policy = CommandPolicy_Evaluate(action, Session_GetState());
  if (policy == COMMAND_POLICY_REJECTED)
  {
    const char *reply = CommandPolicy_Rejection(action);
    Diagnostics_Record(DIAG_COMMAND_REJECTED, (uint32_t)action,
                       (uint32_t)Session_GetState());
    if (reply != NULL)
    {
      (void)UsbTest_SendText(reply);
    }
    return;
  }
  if (strcmp(command, "SLEEP START") == 0)
  {
#if defined(SPOOKY_IPC_SMOKE)
    (void)UsbTest_SendText("ERR SLEEP unavailable in IPC smoke build; use Debug\r\n");
#else
    PrototypePower_RequestSleep();
    (void)UsbTest_SendText(
      "OK SLEEP START; CDC will disconnect; updates continue on AUX UART7\r\n");
#endif
    return;
  }
  if (IpcSmokeCli_HandleCommand(command))
  {
    return;
  }
  if (MagnetometerTest_HandleCommand(command))
  {
    return;
  }
  if (MatrixAdapter_HandleCommand(command))
  {
    return;
  }
  if (UiBoardTest_HandleCommand(command))
  {
    return;
  }
  if ((strncmp(command, "WAV", 3U) == 0) &&
      ((command[3] == '\0') || (command[3] == ' ') ||
       (command[3] == '\t')))
  {
    if (SdTest_IsActive())
    {
      (void)UsbTest_SendText("ERR WAV unavailable while SD test active\r\n");
    }
    else
    {
      (void)WavTransfer_HandleCommand(command);
    }
    return;
  }
  if (RadioRecorder_HandleCommand(command, AudioPath_IsRunning()))
  {
    return;
  }
  if (Session_IsActive() &&
      ((strcmp(command, "SD") == 0) || (strcmp(command, "SD STATUS") == 0)))
  {
    RadioRecorder_SendStorageStatus();
    return;
  }
  if (SdTest_HandleCommand(command))
  {
    return;
  }
  if ((strcmp(command, "BATTERY") == 0) ||
      (strcmp(command, "BATTERY READ") == 0) ||
      (strcmp(command, "BATTERY STATUS") == 0))
  {
    BoardDiagnostics_SendBatteryStatus(false, !RadioRecorder_IsCapturing());
    return;
  }
  if ((strcmp(command, "CHARGE") == 0) ||
      (strcmp(command, "CHARGE READ") == 0) ||
      (strcmp(command, "CHARGE STATUS") == 0))
  {
    BoardDiagnostics_SendBatteryStatus(true, !RadioRecorder_IsCapturing());
    return;
  }
  if (ClassicAdapter_HandleCommand(command))
  {
    return;
  }
  if (AudioPath_HandleCommand(command))
  {
    return;
  }
  if (!AudioPath_IsRunning())
  {
    (void)UsbTest_SendText("ERR RADIO audio path is not running\r\n");
    return;
  }
  if (strcmp(command, "STATUS") == 0)
  {
    RadioAdapter_SendStatus();
    return;
  }
  if ((strcmp(command, "VOLUME") == 0) ||
      (strcmp(command, "VOLUME READ") == 0) ||
      (strcmp(command, "VOLUME STATUS") == 0))
  {
    if (!CodecVolume_RefreshVolume())
    {
      (void)UsbTest_SendText("ERR VOLUME ADC read failed\r\n");
      return;
    }
    VolumeUsbSendStatus();
    return;
  }
  if (strcmp(command, "BAND") == 0)
  {
    RadioUsbSendBand();
    return;
  }
  if ((strncmp(command, "BAND", 4U) == 0) &&
      ((command[4] == ' ') || (command[4] == '\t')))
  {
    if (!RadioParseBand(&command[5], &target_band))
    {
      (void)UsbTest_SendText("ERR usage: BAND FM|AM|SW|LW\r\n");
      return;
    }
    if (!RadioAdapter_RequestBand((uint32_t)target_band))
    {
      (void)UsbTest_SendText("ERR BUSY\r\n");
    }
    return;
  }

  if (strcmp(command, "UP") == 0)
  {
    posted = RadioAdapter_RequestStep(true);
  }
  else if (strcmp(command, "DOWN") == 0)
  {
    posted = RadioAdapter_RequestStep(false);
  }
  else if ((strncmp(command, "TUNE", 4U) == 0) &&
           ((command[4] == ' ') || (command[4] == '\t')))
  {
    if (!RadioParseFrequencyKHz(&command[5], &frequency_khz))
    {
      (void)UsbTest_SendText("ERR usage: TUNE <frequency-kHz>\r\n");
      return;
    }
    /* The Radio machine checks the range against the band the tune will run
     * in, which a band switch still queued or in flight may change
     * (54w.12.2); an out-of-range tune is answered ERR <band> range. */
    posted = RadioAdapter_RequestTune(frequency_khz);
  }
  else
  {
    (void)UsbTest_SendText("ERR unknown command; type HELP\r\n");
    return;
  }

  /* The Radio machine answers when the tune completes, fails or is superseded
   * (RadioSm); only a rejected post is answered here. */
  if (!posted)
  {
    (void)UsbTest_SendText("ERR BUSY\r\n");
  }
}

static void RadioAudio_Service(void)
{
  CodecVolumeStatus codec_status;
  AudioPathStatus audio_status;

  if (!AudioPath_GetStatus(&audio_status) || !audio_status.running)
  {
    return;
  }
  if (audio_status.fault_flags != 0U)
  {
    (void)CodecVolume_SetTransitionMuted(true);
    AudioPath_MarkStopped();
    BSP_LED_Off(LED_GREEN);
    BSP_LED_On(LED_RED);
    printf("[bridge] FAIL: runtime SAI/DMA flags=0x%08lX; output muted\r\n",
           (unsigned long)audio_status.fault_flags);
    RadioAdapter_ReportAudioFault();
    return;
  }

  RadioAdapter_Service();

  if (!CodecVolume_Service())
  {
    (void)CodecVolume_GetStatus(&codec_status);
    AudioPath_ReportFault(
      (codec_status.last_error == CODEC_VOLUME_ERROR_OUTPUT)
        ? AUDIO_PATH_FAULT_CODEC_OUTPUT : AUDIO_PATH_FAULT_VOLUME_ADC);
    RadioAdapter_ReportAudioFault();
  }
}

static void Bringup_Run(void)
{
  CodecVolumeStatus codec_status;

  BSP_LED_Off(LED_GREEN);
  BSP_LED_Off(LED_YELLOW);
  BSP_LED_Off(LED_RED);

  printf("\r\n========================================\r\n");
  printf("Spooky Box radio-to-headphone bring-up\r\n");
  printf("CM7 64 MHz HSI; FM/AM/SW/LW USB-tunable, 48 kHz stereo\r\n");
  (void)CodecVolume_GetStatus(&codec_status);
  printf("Jack detect: line-in PA5=%s, headphone PE0=%s\r\n",
         codec_status.line_in_inserted ? "inserted" : "empty",
         codec_status.headphone_inserted ? "inserted" : "empty");
  printf("========================================\r\n");

  if (RadioAudioStart())
  {
    BSP_LED_On(LED_GREEN);
    printf("\r\n[summary] PASS: radio audio is routed to the headphone codec\r\n");
    printf("[summary] Output follows PE0 jack detect and the PF10 volume pot\r\n");
  }
  else
  {
    BSP_LED_On(LED_RED);
    printf("\r\n[summary] FAIL: radio/audio stream did not start; hardware quiesced\r\n");
  }
}

static void SleepMakePeripheralPinsHighImpedance(void)
{
  GPIO_InitTypeDef gpio = {0};

  gpio.Mode = GPIO_MODE_ANALOG;
  gpio.Pull = GPIO_NOPULL;

  /* Stop all push-pull clocks/data that reach the switchable 3.3 V rail. */
  gpio.Pin = SAI_CODEC_MCLK_A_Pin | SAI_CODEC_SD_B_Pin |
             SAI_CODEC_FS_A_Pin | SAI_CODEC_SCK_A_Pin |
             SAI_CODEC_SD_A_Pin;
  HAL_GPIO_Init(GPIOE, &gpio);
  gpio.Pin = SAI_RADIO_SD_Pin | SAI_RADIO_FS_Pin | SAI_RADIO_SCK_Pin;
  HAL_GPIO_Init(GPIOD, &gpio);
  gpio.Pin = RADIO_RCLK_Pin;
  HAL_GPIO_Init(RADIO_RCLK_GPIO_Port, &gpio);
  gpio.Pin = MIC_CKOUT_Pin | MIC_DATIN_Pin;
  HAL_GPIO_Init(GPIOC, &gpio);
}

static void SleepStopRadioAudio(void)
{
  if (AudioPath_IsRunning())
  {
    (void)CodecVolume_SetTransitionMuted(true);
    RadioControl_PowerDown();
  }
  AudioPath_Stop();
  HAL_NVIC_DisableIRQ(DMA2_Stream0_IRQn); /* DFSDM microphone capture */
  RadioControl_HoldReset();
  HAL_GPIO_WritePin(AMP_SD_GPIO_Port, AMP_SD_Pin, GPIO_PIN_RESET);
  HAL_GPIO_WritePin(LED_MATRIX_EN_GPIO_Port, LED_MATRIX_EN_Pin,
                    GPIO_PIN_RESET);
  SleepMakePeripheralPinsHighImpedance();

  __HAL_RCC_SAI1_CLK_DISABLE();
  __HAL_RCC_SAI2_CLK_DISABLE();
  __HAL_RCC_DMA1_CLK_DISABLE();
  __HAL_RCC_DMA2_CLK_DISABLE();
  __HAL_RCC_DFSDM1_CLK_DISABLE();
  __HAL_RCC_I2C1_CLK_DISABLE();
  __HAL_RCC_I2C4_CLK_DISABLE();
}

/* USER CODE END 0 */

/**
  * @brief  The application entry point.
  * @retval int
  */
int main(void)
{

/* USER CODE BEGIN Boot_Mode_Sequence_0 */
#if defined(DUAL_CORE_BOOT_SYNC_SEQUENCE)
  int32_t timeout;
#endif /* DUAL_CORE_BOOT_SYNC_SEQUENCE */
/* USER CODE END Boot_Mode_Sequence_0 */

/* USER CODE BEGIN Boot_Mode_Sequence_1 */
#if defined(DUAL_CORE_BOOT_SYNC_SEQUENCE)
  /* Wait until CPU2 boots and enters in stop mode or timeout*/
  timeout = 0xFFFF;
  while((__HAL_RCC_GET_FLAG(RCC_FLAG_D2CKRDY) != RESET) && (timeout-- > 0));
  if ( timeout < 0 )
  {
  Error_Handler();
  }
#endif /* DUAL_CORE_BOOT_SYNC_SEQUENCE */
/* USER CODE END Boot_Mode_Sequence_1 */
  /* MCU Configuration--------------------------------------------------------*/

  /* Reset of all peripherals, Initializes the Flash interface and the Systick. */
  HAL_Init();

  /* USER CODE BEGIN Init */
  Diagnostics_Init();

  /* USER CODE END Init */

  /* Configure the system clock */
  SystemClock_Config();

  /* Configure the peripherals common clocks */
  PeriphCommonClock_Config();
  BuildIdentity_Init();
#if defined(SPOOKY_ISR_TIMING_QUALIFICATION)
  IsrTiming_Install(); /* After the clock is final: thresholds use SystemCoreClock. */
#endif
/* USER CODE BEGIN Boot_Mode_Sequence_2 */
#if defined(SPOOKY_IPC_SMOKE)
  IpcSmoke_Init(); /* M4 is still held in its boot STOP wait. */
#endif
#if defined(DUAL_CORE_BOOT_SYNC_SEQUENCE)
/* When system initialization is finished, Cortex-M7 will release Cortex-M4 by means of
HSEM notification */
/*HW semaphore Clock enable*/
__HAL_RCC_HSEM_CLK_ENABLE();
/*Take HSEM */
HAL_HSEM_FastTake(HSEM_ID_0);
/*Release HSEM in order to notify the CPU2(CM4)*/
HAL_HSEM_Release(HSEM_ID_0,0);
/* wait until CPU2 wakes up from stop mode */
timeout = 0xFFFF;
while((__HAL_RCC_GET_FLAG(RCC_FLAG_D2CKRDY) == RESET) && (timeout-- > 0));
if ( timeout < 0 )
{
Error_Handler();
}
#endif /* DUAL_CORE_BOOT_SYNC_SEQUENCE */
/* USER CODE END Boot_Mode_Sequence_2 */

  /* Initialize all configured peripherals */
  MX_GPIO_Init();
  MX_DMA_Init();
  MX_I2C1_Init();
  MX_I2C2_Init();
  MX_I2C4_Init();
  MX_SAI1_Init();
  MX_ADC3_Init();
  MX_DFSDM1_Init();
#if !defined(SPOOKY_MINIMAL_BRINGUP)
  MX_SDMMC1_SD_Init();
  MX_SAI2_Init();
  MX_SPI6_Init();
#endif
  /* Initialize leds */
  BSP_LED_Init(LED_GREEN);
  BSP_LED_Init(LED_YELLOW);
  BSP_LED_Init(LED_RED);

  /* Initialize USER push-button, will be used to trigger an interrupt each time it's pressed.*/
  BSP_PB_Init(BUTTON_USER, BUTTON_MODE_EXTI);

  /* Route the bounded printf logger through the backplane AUX UART instead of the
   * Nucleo ST-LINK VCP on USART3. */
  if (!BoardDiagnostics_StartConsole())
  {
    Error_Handler();
  }
  printf("\r\n[uart] Spooky Probe console on UART7: PE8 TX, PE7 RX, 115200 8N1\r\n");

  /* Infinite loop */
  /* USER CODE BEGIN WHILE */
  Bringup_Run();
  StorageService_Init(&hsd1);
  SdTest_Start();
  RadioRecorder_Init(&hdfsdm1_filter0);
  AppDispatch_Init();
  RadioAdapter_ReportStarted(AudioPath_IsRunning());
  WavTransfer_Init();
  if (!FuelGaugeTest_Start(&hi2c2))
  {
    BSP_LED_On(LED_RED);
  }
  if (!MagnetometerTest_Start(&hi2c2))
  {
    BSP_LED_On(LED_RED);
  }
  if (!UiBoardTest_Start(&hi2c2, &hspi6))
  {
    BSP_LED_On(LED_RED);
  }
  MatrixAdapter_Init();
  UsbTest_SetLineHandler(UsbCliCommand);
  if (!UsbTest_Start())
  {
    BSP_LED_On(LED_RED);
  }
  while (1)
  {
    static uint32_t previous_loop_started_ms;
    static bool previous_loop_capturing;
    static bool foreground_started;
    uint32_t loop_started_ms = HAL_GetTick();
    bool loop_capturing = RadioRecorder_IsCapturing();

    /* Capture state is sampled at each loop-start boundary, so the pass that
     * opens and preallocates the file before capture starts is excluded. */
    if (foreground_started)
    {
      Diagnostics_ObserveForeground(FOREGROUND_SERVICE_LOOP,
        loop_started_ms - previous_loop_started_ms,
        previous_loop_capturing && loop_capturing);
    }
    previous_loop_started_ms = loop_started_ms;
    previous_loop_capturing = loop_capturing;
    foreground_started = true;

    /* USER CODE END WHILE */

    /* USER CODE BEGIN 3 */
#if defined(SPOOKY_IPC_SMOKE)
    RUN_FOREGROUND(FOREGROUND_SERVICE_IPC, IpcSmoke_Service());
#endif
    RUN_FOREGROUND(FOREGROUND_SERVICE_AUDIO, RadioAudio_Service());
    RUN_FOREGROUND(FOREGROUND_SERVICE_RECORDER, RadioRecorder_Service());
    RUN_FOREGROUND(FOREGROUND_SERVICE_FUEL,
      FuelGaugeTest_Service(!RadioRecorder_IsCapturing()));
    RUN_FOREGROUND(FOREGROUND_SERVICE_USB, UsbTest_Service());
    RUN_FOREGROUND(FOREGROUND_SERVICE_WAV, WavTransfer_Service());
#if defined(SPOOKY_LOGGER_LOAD_QUALIFICATION)
    RUN_FOREGROUND(FOREGROUND_SERVICE_LOGGER, LoggerLoad_Service());
#endif
    RUN_FOREGROUND(FOREGROUND_SERVICE_LOGGER, TargetLogger_Service());
    RUN_FOREGROUND(FOREGROUND_SERVICE_DIAGNOSTICS, Diagnostics_Service());
    RUN_FOREGROUND(FOREGROUND_SERVICE_UI,
      UiBoardTest_Service(RadioRecorder_IsCapturing()));
    RUN_FOREGROUND(FOREGROUND_SERVICE_MATRIX, MatrixAdapter_Service());
    RUN_FOREGROUND(FOREGROUND_SERVICE_SD_TEST, SdTest_Service());
    RUN_FOREGROUND(FOREGROUND_SERVICE_POWER,
      PrototypePower_Service(SleepStopRadioAudio));
    RUN_FOREGROUND(FOREGROUND_SERVICE_MAGNETOMETER,
      MagnetometerTest_Service(!RadioRecorder_IsCapturing()));
    RUN_FOREGROUND(FOREGROUND_SERVICE_ACTIVITY, RadioAdapter_ServiceActivity());
    RUN_FOREGROUND(FOREGROUND_SERVICE_CLASSIC, ClassicAdapter_Service());
    RUN_FOREGROUND(FOREGROUND_SERVICE_DISPATCH, AppDispatch_Service());
    HAL_Delay(5U);
  }
  /* USER CODE END 3 */
}

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
/* USER CODE BEGIN 4 */

void RTC_WKUP_IRQHandler(void)
{
  PrototypePower_OnRtcWake();
}

void BSP_PB_Callback(Button_TypeDef Button)
{
  if (Button == BUTTON_USER)
  {
    PrototypePower_OnUserButton();
  }
}

void DMA2_Stream0_IRQHandler(void)
{
  HAL_DMA_IRQHandler(&hdma_dfsdm1_flt0);
}

/* USER CODE END 4 */
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
