dwight9339/spooky_box_proto/CM7/App/diagnostics.c

#include "diagnostics.h"
#include "app_events.h"
#include "target_logger.h"
#include "usb_test.h"
#include <stdio.h>
#include <string.h>
#if defined(SPOOKY_IPC_SMOKE)
#include "ipc_smoke.h"
#endif

typedef enum {REPLY_IDLE, REPLY_STATUS, REPLY_QUEUE, REPLY_LOG, REPLY_LAST,
  REPLY_DUMP_HEADER, REPLY_DUMP_ROWS, REPLY_DUMP_END, REPLY_HELP,
  REPLY_LATENCY_HEADER, REPLY_LATENCY_ROWS, REPLY_LATENCY_END, REPLY_USB} ReplyState;
static DiagHistory history;
static ReplyState reply;
static uint32_t dump_sequence;
static uint32_t dump_remaining;
static uint32_t dump_count;
static uint32_t dump_gaps;
static uint32_t last_send_ms;
static uint32_t help_index;
static uint32_t last_service_ms;
static uint32_t last_log_sample_ms;
static uint32_t last_log_drops;
static uint32_t last_log_errors;
static uint32_t last_queue_losses;
static bool service_started;
static uint32_t foreground_max_ms[FOREGROUND_SERVICE_COUNT];
static uint32_t foreground_violations[FOREGROUND_SERVICE_COUNT];
static uint32_t latency_index;
#if defined(SPOOKY_IPC_SMOKE)
static uint32_t last_ipc_link = UINT32_MAX;
#endif

static const char *const help_lines[] = {
  "OK RADIO BAND [FM|AM|SW|LW] | TUNE <kHz> | UP | DOWN | STATUS\r\n",
  "OK VOLUME READ | BATTERY READ | CHARGE STATUS | SLEEP START\r\n",
  "OK DIAG IDENTITY (build, boot epoch, reset flags, capabilities)\r\n",
  "OK IPC STATUS | LOG STATUS | DIAG STATUS|QUEUE|USB|LATENCY|LAST|DUMP|STOP\r\n",
  "OK MAG READ|STATUS|STREAM START [ms]|STOP\r\n",
  "OK EMF READ|STATUS|ZERO|STREAM START [ms]|STOP\r\n",
  "OK RECORD STATUS|RESULT|LATENCY|START [seconds]|STOP\r\n",
  "OK WAV FETCH REC###.WAV|ABORT (binary protocol v1)\r\n",
  "OK SD STATUS|INFO|REINIT|STRESS [size-MiB] [passes]|STRESS STOP|CLEAN|FORMAT [CONFIRM]\r\n",
  "OK UI STATUS|WATCH START|WATCH STOP|LEDS|MATRIX PROBE|MATRIX ANIMATE|MATRIX ORIENT|"
    "MATRIX FEEDBACK [ON|OFF]|MATRIX TRAIL ON|OFF|"
    "DISPLAY TEST [0|2]|DISPLAY OFF|OFF\r\n",
  "OK CLASSIC [RUN|PAUSE|TOGGLE|DIR|RATE n|DIST n|EDGE n|HOLD n|ACTIVITY]\r\n"
};

void Diagnostics_Init(void)
{
  DiagHistory_Init(&history); /* Before runtime IRQ producers are enabled. */
  reply = REPLY_IDLE;
  service_started = false;
  last_log_drops = 0U;
  last_log_errors = 0U;
  last_queue_losses = 0U;
  (void)memset(foreground_max_ms, 0, sizeof(foreground_max_ms));
  (void)memset(foreground_violations, 0, sizeof(foreground_violations));
#if defined(SPOOKY_IPC_SMOKE)
  last_ipc_link = UINT32_MAX;
#endif
  last_log_sample_ms = HAL_GetTick();
  Diagnostics_Record(DIAG_BOOT, 1U, 7U); /* Diagnostic schema v1, core M7. */
}

void Diagnostics_ObserveForeground(ForegroundService service,
                                   uint32_t duration_ms, bool recording)
{
  uint32_t budget_ms;
  if (!recording || ((uint32_t)service >= FOREGROUND_SERVICE_COUNT)) return;
  if (duration_ms > foreground_max_ms[service])
    foreground_max_ms[service] = duration_ms;
  budget_ms = ForegroundBudget_Milliseconds(service);
  if (duration_ms > budget_ms)
  {
    ++foreground_violations[service];
    Diagnostics_Record(DIAG_FOREGROUND_BUDGET, (uint32_t)service, duration_ms);
  }
}

void Diagnostics_Record(DiagEventType type, uint32_t arg0, uint32_t arg1)
{
  uint32_t mask = __get_PRIMASK();
  __disable_irq();
  DiagHistory_Add(&history, HAL_GetTick(), type, arg0, arg1);
  __set_PRIMASK(mask);
}

static DiagSummary Summary(void)
{
  DiagSummary out;
  uint32_t mask = __get_PRIMASK();
  __disable_irq();
  out = history.summary;
  __set_PRIMASK(mask);
  return out;
}

bool Diagnostics_HandleCommand(const char *command)
{
  DiagSummary summary;
  bool help = strcmp(command, "HELP") == 0;
  bool diag = (strncmp(command, "DIAG", 4U) == 0) &&
    ((command[4] == '\0') || (command[4] == ' ') || (command[4] == '\t'));
  bool log = (strncmp(command, "LOG", 3U) == 0) &&
    ((command[3] == '\0') || (command[3] == ' ') || (command[3] == '\t'));
  if (!help && !diag && !log) return false;
  if (strcmp(command, "DIAG STOP") == 0)
  {
    reply = REPLY_IDLE;
    (void)UsbTest_SendText("OK DIAG STOP\r\n");
    return true;
  }
  if (reply != REPLY_IDLE)
  {
    (void)UsbTest_SendText("ERR DIAG reply active; use DIAG STOP\r\n");
    return true;
  }
  if (help) { help_index = 0U; reply = REPLY_HELP; }
  else if (strcmp(command, "LOG STATUS") == 0) reply = REPLY_LOG;
  else if (strcmp(command, "DIAG STATUS") == 0) reply = REPLY_STATUS;
  else if (strcmp(command, "DIAG QUEUE") == 0) reply = REPLY_QUEUE;
  else if (strcmp(command, "DIAG USB") == 0) reply = REPLY_USB;
  else if (strcmp(command, "DIAG LATENCY") == 0)
  {
    latency_index = 0U;
    reply = REPLY_LATENCY_HEADER;
  }
  else if (strcmp(command, "DIAG LAST") == 0) reply = REPLY_LAST;
  else if (strcmp(command, "DIAG DUMP") == 0)
  {
    summary = Summary();
    dump_sequence = summary.oldest_sequence;
    dump_remaining = dump_count = summary.count;
    dump_gaps = 0U;
    reply = REPLY_DUMP_HEADER;
  }
  else
  {
    (void)UsbTest_SendText("ERR usage: LOG STATUS | DIAG STATUS|QUEUE|USB|LATENCY|LAST|DUMP|STOP\r\n");
    return true;
  }
  last_send_ms = HAL_GetTick();
  return true;
}

static void FormatEvent(char *line, size_t size, const char *prefix, const DiagEvent *e)
{
  (void)snprintf(line, size, "%s SEQ=%lu MS=%lu EVENT=%s A=%lu B=%lu\r\n",
    prefix, (unsigned long)e->sequence, (unsigned long)e->tick_ms,
    DiagHistory_Name(e->type), (unsigned long)e->arg0, (unsigned long)e->arg1);
}

static void SendOneLine(uint32_t now)
{
  char line[256]; /* USB CDC's existing maximum; each response is one line. */
  bool gap = false;
  if (reply == REPLY_IDLE) return;
  if ((now - last_send_ms) >= 5000U) { reply = REPLY_IDLE; return; }
  if (reply == REPLY_STATUS)
  {
    DiagSummary s = Summary();
    (void)snprintf(line, sizeof(line),
      "OK DIAG V=1 CORE=7 COUNT=%lu OVERWRITTEN=%lu SD_MAX_MS=%lu "
      "LOOP_MAX_MS=%lu RADIO_OVR=%lu PDM_OVR=%lu SD_ERR=%lu AUDIO_ERR=%lu "
      "HAS_FAULT=%u\r\n", (unsigned long)s.count, (unsigned long)s.overwritten,
      (unsigned long)s.max_sd_write_ms, (unsigned long)s.max_loop_gap_ms,
      (unsigned long)s.totals[DIAG_RADIO_OVERRUN],
      (unsigned long)s.totals[DIAG_PDM_OVERRUN], (unsigned long)s.totals[DIAG_SD_ERROR],
      (unsigned long)s.totals[DIAG_AUDIO_ERROR], (unsigned int)s.have_fault);
  }
  else if (reply == REPLY_QUEUE)
  {
    EvqStats q;
    AppEvents_GetStats(&q);
    (void)snprintf(line, sizeof(line),
      "OK DIAG QUEUE CAP=%lu RESERVE=%lu COUNT=%lu PEAK=%lu POSTED=%lu "
      "DISPATCHED=%lu REJ_INPUT=%lu REJ_CMD=%lu REJ_INTERNAL=%lu RECONCILES=%lu "
      "MAX_WAIT_MS=%lu\r\n", (unsigned long)q.capacity, (unsigned long)q.reserve,
      (unsigned long)q.count, (unsigned long)q.high_water, (unsigned long)q.posted,
      (unsigned long)q.dispatched, (unsigned long)q.rejected[EVQ_CLASS_INPUT],
      (unsigned long)q.rejected[EVQ_CLASS_EXTERNAL_COMMAND],
      (unsigned long)q.rejected[EVQ_CLASS_INTERNAL], (unsigned long)q.reconciles,
      (unsigned long)q.max_wait_ms);
  }
  else if (reply == REPLY_USB)
  {
    UsbTestRxStats u;
    UsbTest_GetRxStats(&u);
    (void)snprintf(line, sizeof(line),
      "OK DIAG USB RX_PACKETS=%lu RX_PAUSES=%lu RX_OVERRUNS=%lu RX_QUEUED=%lu "
      "RX_PAUSED=%u\r\n", (unsigned long)u.packets, (unsigned long)u.pauses,
      (unsigned long)u.overruns, (unsigned long)u.queued, u.paused ? 1U : 0U);
  }
  else if (reply == REPLY_LOG)
  {
    TargetLoggerStats s;
    TargetLogger_GetStats(&s);
    (void)snprintf(line, sizeof(line),
      "OK LOG QUEUED=%lu PEAK=%lu DROP_WRITES=%lu DROP_BYTES=%lu "
      "TX_LOST=%lu TX_BYTES=%lu TX_ERRORS=%lu CONTEXT=%lu FLIGHT=%lu\r\n",
      (unsigned long)s.queued_bytes, (unsigned long)s.high_water,
      (unsigned long)s.dropped_writes, (unsigned long)s.dropped_bytes,
      (unsigned long)s.transport_dropped_bytes, (unsigned long)s.transmitted_bytes,
      (unsigned long)s.transport_errors, (unsigned long)s.rejected_context,
      (unsigned long)s.in_flight);
  }
  else if (reply == REPLY_LAST)
  {
    DiagSummary s = Summary();
    if (s.have_fault) FormatEvent(line, sizeof(line), "OK DIAG LAST", &s.last_fault);
    else (void)snprintf(line, sizeof(line), "OK DIAG LAST NONE\r\n");
  }
  else if (reply == REPLY_DUMP_HEADER)
    (void)snprintf(line, sizeof(line), "OK DIAG DUMP V=1 CORE=7 FIRST=%lu COUNT=%lu\r\n",
      (unsigned long)dump_sequence, (unsigned long)dump_count);
  else if (reply == REPLY_LATENCY_HEADER)
    (void)snprintf(line, sizeof(line),
      "OK DIAG LATENCY BLOCK_MS=%lu SERVICES=%lu recording-only=1\r\n",
      (unsigned long)FOREGROUND_RECORDER_BLOCK_MS,
      (unsigned long)FOREGROUND_SERVICE_COUNT);
  else if (reply == REPLY_LATENCY_ROWS)
  {
    ForegroundService service = (ForegroundService)latency_index;
    (void)snprintf(line, sizeof(line),
      "DIAG LATENCY ID=%lu SERVICE=%s BUDGET_MS=%lu MAX_MS=%lu VIOLATIONS=%lu\r\n",
      (unsigned long)latency_index, ForegroundBudget_Name(service),
      (unsigned long)ForegroundBudget_Milliseconds(service),
      (unsigned long)foreground_max_ms[service],
      (unsigned long)foreground_violations[service]);
  }
  else if (reply == REPLY_LATENCY_END)
    (void)snprintf(line, sizeof(line), "OK DIAG LATENCY END\r\n");
  else if (reply == REPLY_DUMP_ROWS)
  {
    DiagEvent event;
    uint32_t mask = __get_PRIMASK();
    __disable_irq();
    gap = !DiagHistory_Get(&history, dump_sequence, &event);
    __set_PRIMASK(mask);
    if (gap)
      (void)snprintf(line, sizeof(line), "DIAG GAP SEQ=%lu\r\n", (unsigned long)dump_sequence);
    else FormatEvent(line, sizeof(line), "DIAG EVENT", &event);
  }
  else if (reply == REPLY_HELP)
    (void)snprintf(line, sizeof(line), "%s", help_lines[help_index]);
  else
    (void)snprintf(line, sizeof(line), "OK DIAG END COUNT=%lu GAPS=%lu\r\n",
      (unsigned long)dump_count, (unsigned long)dump_gaps);

  if (!UsbTest_SendText(line)) return; /* Preserve cursor until accepted. */
  last_send_ms = now;
  if (reply == REPLY_DUMP_HEADER)
    reply = dump_remaining != 0U ? REPLY_DUMP_ROWS : REPLY_DUMP_END;
  else if (reply == REPLY_LATENCY_HEADER)
    reply = REPLY_LATENCY_ROWS;
  else if (reply == REPLY_LATENCY_ROWS)
  {
    if (++latency_index == FOREGROUND_SERVICE_COUNT)
      reply = REPLY_LATENCY_END;
  }
  else if (reply == REPLY_LATENCY_END)
    reply = REPLY_IDLE;
  else if (reply == REPLY_DUMP_ROWS)
  {
    if (gap) ++dump_gaps;
    ++dump_sequence;
    if (--dump_remaining == 0U) reply = REPLY_DUMP_END;
  }
  else if (reply == REPLY_HELP)
  {
    if (++help_index == sizeof(help_lines) / sizeof(help_lines[0])) reply = REPLY_IDLE;
  }
  else reply = REPLY_IDLE;
}

void Diagnostics_Service(void)
{
  uint32_t now = HAL_GetTick();
  if (service_started && ((now - last_service_ms) >= 50U))
    Diagnostics_Record(DIAG_LOOP_STALL, now - last_service_ms, 0U);
  last_service_ms = now;
  service_started = true;
#if defined(SPOOKY_IPC_SMOKE)
  const IpcSmokeDiagnostics *ipc = IpcSmoke_GetDiagnostics();
  uint32_t link = (uint32_t)IpcSmoke_Link(&ipc->health, now);
  if (link != last_ipc_link)
  {
    Diagnostics_Record(DIAG_IPC_LINK, link, (uint32_t)ipc->health.error);
    last_ipc_link = link;
  }
#endif
  if ((now - last_log_sample_ms) >= 1000U)
  {
    TargetLoggerStats s;
    TargetLogger_GetStats(&s);
    if (s.dropped_writes != last_log_drops)
      Diagnostics_Record(DIAG_LOG_LOSS, s.dropped_writes, s.dropped_bytes);
    if (s.transport_errors != last_log_errors)
      Diagnostics_Record(DIAG_LOG_ERROR, s.transport_errors, s.transport_dropped_bytes);
    last_log_drops = s.dropped_writes;
    last_log_errors = s.transport_errors;
    /* Decision 0007 item 8: a rejected internal event is a design error. */
    EvqStats q;
    AppEvents_GetStats(&q);
    if (q.rejected[EVQ_CLASS_INTERNAL] != last_queue_losses)
      Diagnostics_Record(DIAG_EVENT_QUEUE_LOSS, q.rejected[EVQ_CLASS_INTERNAL], q.high_water);
    last_queue_losses = q.rejected[EVQ_CLASS_INTERNAL];
    last_log_sample_ms = now;
  }
  SendOneLine(now);
}
