dwight9339/spooky_box_proto/(commit log)

2026-09-22 Reorganize reference folder, rename schematics, add UI board schematic
2026-09-22 Add UI board bring-up tests
2026-09-24 Add bounded M7 diagnostics and opt-in dual-core IPC smoke tests
    Extract board diagnostics and charging-sleep policy, replace blocking UART logging with a bounded interrupt-driven queue, and add numeric event history with USB diagnostics. Add isolated IPC smoke/mismatch presets and shared-memory validation without changing normal M4 sleep behavior.
    Validation: Debug, Release, IpcSmoke and IpcMismatch firmware builds passed; native target suites pass 2/2. User bench results show version rejection, advancing IPC acknowledgements, successful 60-second recordings, and link recovery after reboot. Full bench evidence and remaining checks are recorded in the following documentation commit.
    [board_diagnostics.c, board_diagnostics.h, diag_history.c, diag_history.h, diagnostics.c, diagnostics.h, fake_hal.c, fake_hal.h]
2026-09-24 Document device experience, Windows bench plan, and initial hardware results
    Add interaction/control-map inputs, an incremental modularization roadmap, the probe v1 contract, and a Windows-first bench automation plan. Record display/SYSOFF observations, three successful short recordings, IPC progress before and after recording, deliberate version rejection, and user-observed reboot recovery.
    Link the target and probe source checkpoints and distinguish supplied hardware evidence from remaining WAV, diagnostic, overload, sleep, and recovery checks. Spooky Bench implementation remains pending.
    [spooky_box_control_map.xlsx]
2026-09-24 Add bounded SWD reset and paired flash controls
    [artifacts.py, cli.py, config.py, firmware.py, openocd.py, process_io.py, runner.py]
2026-09-25 Extract codec and volume service from M7 main
    Move SGTL5000 control, SAI1 MCLK setup, ADC3 volume-pot sampling and
    headphone/line-in jack state into CM7/App/codec_volume_service with a
    narrow init/service/status interface. The register sequence, volume
    mapping, 10 ms polling cadence and radio error flags are unchanged.
    Band-switch muting becomes a transition gate owned by the service.
    Record the bench regression (jack, pot, band switch, 60 s recording).
    Beads: full_spooky_proto-8lw.1
    [codec_volume_service.c, codec_volume_service.h, main.c]
2026-09-25 Record Beads roadmap tracking and agent handoff rules
    Point the README and design docs at Beads for task status, reconcile
    roadmap text with the September 24 bench evidence, and record the
    initial UI and I2C2 ownership decision. Require agents to append
    progress notes to claimed Beads issues so interrupted work can be
    resumed.
2026-09-25 Extract radio control and tune transition state
    Move Si4735 control (reset, SW antenna switch, band table, per-band
    frequency memory, tune target/result and fault state) into
    CM7/App/radio_control_service behind a narrow API. Command bytes,
    properties, delays and timeouts are unchanged. main.c keeps the audio
    DMA bridge and USB formatting, and sequences muting and the DMA copy
    around band changes. Recording-time tuning guards are unchanged.
    Record the bench regression (tune, step, band memory, recording guard,
    sleep/wake).
    Beads: full_spooky_proto-8lw.2
    [main.c, radio_control_service.c, radio_control_service.h]
2026-09-25 Separate raw capture and monitored audio service
    Move radio capture and headphone monitoring into
    CM7/App/audio_path_service: SAI2 A receive and DMA1 Stream 4 setup, the
    SAI1 A transmit DMA, both DMA buffers, counters, fault flags, SAI
    callbacks and their interrupt handlers. Each received half-buffer goes
    unchanged to the recorder before a separate read-only monitor stage
    renders the headphone buffer, the future microphone mix/PTT point.
    Buffer placement and interrupt-path code size are unchanged.
    Record the bench regression (tuning, band switches, two 60 s recordings
    with CRC-verified WAV inspection).
    Beads: full_spooky_proto-8lw.3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
2026-09-25 docs: adopt constitution v1.1.0 and reorganize docs by class
    Ratify the Spooky Box constitution (Spec Kit root under spec/) with seven
    principles distilled from the product vision, a Documentation Classes
    section, and governance that protects authoritative documents behind
    explicit proposals. AGENTS.md and CLAUDE.md now require a constitution
    check and forbid unapproved edits to protected documents.
    Move product intent (philosophy, modes and interaction, control map) to
    spec/product/ and reorganize docs/ into decisions/, design/, procedures/,
    evidence/ and history/. Extract decision records 0001 (UI and bus
    ownership) and 0002 (Windows-first Spooky Bench), split the IPC and
    logger documents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
    [spooky_box_control_map.xlsx]
2026-09-25 docs: conform living docs to documentation classes
    Split BRINGUP.md into a procedure-only document plus design docs for the
    prototype hardware configuration, the USB CLI contract and the CubeMX
    reconciliation register. Move the Spooky Bench result, safety and
    evidence contract out of the setup and controls procedures into
    docs/design/spooky-bench-contract.md. Replace version/date openers and
    results sections in bench procedures with evidence links and Beads IDs,
    freeze the original Spookyprobe work package under docs/history, point
    architecture milestones at Beads epics, and remove status narration from
    the README. Build/observe now names the UART7 probe console rather than
    the ST-LINK VCP,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
2026-09-25 docs: add development roadmap and tooling-track rule (constitution v1.2.0)
    Add spec/product/roadmap.md with milestones M1-M5, their scope and exit
    criteria, and the user-owned decisions each milestone waits on. Define
    the product track as primary and Spooky Bench/Spookyprobe tooling as a
    supporting track whose purpose is to shorten the product cycle:
    tooling is admitted only for a product consumer or to remove a
    recurring manual validation step from a named milestone gate, ranked by
    human validation time removed, one task in progress at a time, and
    never above the priority of the work it serves.
    Constitution 1.2.0: Principle VII points delivery order at the roadmap
    and carries the tooling r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
2026-09-25 docs: replace stale ST-LINK references with the Spooky Probe setup
    The Pico-based Spooky Probe now provides SWD and the UART7 console and
    the Nucleo's on-board ST-LINK USB is not used. Update bring-up checks,
    the hardware configuration, the USB CLI contract and bench setup to
    match.
2026-09-26 host: add offline wav align for radio-to-mic timing (hpq.1)
    Add `spookybench wav align`, an offline (execution=offline) two-stage
    cross-correlation of the radio and microphone channels that reports
    per-window lag, spread, polarity and drift. Drift is reported only when
    the dominant phase covers at least 75% of detected windows and the lag
    is monotonic or stable within one frame; otherwise the raw endpoint
    delta stays visible with a reason. wav_inspect header parsing moves into
    read_format() for reuse.
    Document the command and offline result semantics in the Spooky Bench
    contract, add the loopback alignment procedure, and archive the
    REC009-REC015 inspection and alignment evidence (startup o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
    [cli.py, wav_align.py, wav_inspect.py]
2026-09-26 docs: add ten-minute recording baseline evidence (jjy.1)
    Record the REC016 (Debug) and REC017 (IpcSmoke) ten-minute runs: WAV
    inspection, IPC load before/during/after, queue high-water, SD write
    maxima, bench power setup and the human listening check, kept separate
    from automated channel statistics.
2026-09-26 host: add unattended recording regression command (5yv.2)
    Add `spookybench test recording-regression`, the single command that
    reruns the baseline recording regression after each M2 extraction. One
    board lock and run directory compose the existing runners: IpcSmoke
    boot smoke, a prerequisite session (recorder idle, SD free space, audio
    path running, codec volume ready), IPC load recording, WAV inspection
    of the recorded file, a WAV-versus-recorder accounting check, optional
    loopback alignment (continuous single-phase lag required) and a
    post-transfer health session (DIAG/LOG, IPC progress, recorder idle,
    same card, free space down by the one new file).
    Gates, observations (tuning, volume, s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
2026-09-27 docs: add behavior model; radio control during recording (54w.13, 54w.14)
    Add docs/design/behavior/ as the table-authoritative behavior model: vocabulary
    and notation, top-level chart with parallel regions, the session machine derived
    from the recorder, and the presentation mapping. Link it from the docs index and
    the architecture's application model.
    Record decisions 0003 (radio control stays available while recording) and 0004
    (radio-track continuity across receiver transitions), accepted 2026-09-27. Apply
    the approved product-intent changes: Field Sessions states that recording and
    capture never change scanning, open decision 17 covers transition noise, and the
    roadmap lists guard qualif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
2026-09-28 docs: control map to Markdown with audited changes; Button 0 session prompt, decision 0005 (54w.18, 54w.19; constitution 1.4.0)
    [spooky_box_control_map.xlsx]
2026-09-28 tooling: StateSmith behavior-model generator and drift check (8lw.12)
    - Pin StateSmith.Cli 0.22.2 in .config/dotnet-tools.json.
    - host/tools/behavior_model.py regenerates CM7/App/sm/<Name>Sm.[ch] and
    docs/design/behavior/<Name>Sm.svg from *Sm.puml; --check fails on
    missing, edited or stale generated files. PlantUML 1.2026.8 is pinned
    by SHA-256. SVGs carry a stamp (diagram hash, PlantUML version, body
    hash) because layout differs with platform fonts.
    - tests: spooky_generated_sm() suppresses unused-parameter warnings on
    generated files only; offline unit tests for the check logic.
    - Document ownership and regeneration in repository-layout.md.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
2026-09-28 feat: InputResolution Button 0 slice as a StateSmith machine (54w.21)
    - docs/design/behavior/InputResolutionSm.puml is the source for the
    Button 0 hold, start/stop prompt, confirm, cancel, withdraw, swallowing
    and release-all behavior of decision 0005; generated C in CM7/App/sm/
    and the rendered SVG are committed.
    - input_resolution_port.[ch]: service interface, diagram guards and
    actions, and integration functions for later firmware wiring (8lw.9,
    54w.4). Guards read a classification taken before dispatch, so a
    pre-held release is delivered exactly once.
    - tests/input_resolution_test.c: 18 host scenarios covering decision 0005
    items 1-9 plus a seeded random exactly-one-outcome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
2026-09-28 feat: M7 application event queue and DIAG QUEUE (8lw.13)
    - CM7/App/event_queue.[ch]: portable FIFO per decision 0007; 32 slots
    with 8 reserved for internal events, reject-newest overrun, one
    reconcile event after rejected input, dispatch limited to events
    queued when the call starts.
    - CM7/App/app_events.[ch]: the firmware queue instance; not yet called
    from the main loop (wired in 8lw.14).
    - DIAG QUEUE reports capacity and counters; a rejected internal event is
    recorded as the new EVENT_QUEUE_LOSS fault.
    - Host tests for ordering, admission, overrun, reconcile, bounded
    dispatch, wrap and counters; DIAG QUEUE and loss-fault tests.
    - Document the reply format, event 14 and the que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
2026-09-28 feat: Session machine in shadow mode beside the recorder (8lw.14)
    - docs/design/behavior/SessionSm.puml generates CM7/App/sm/SessionSm.[ch];
    session_port.[ch] holds the service interface, diagram guards/actions
    and integration functions.
    - Shadow mode: the recorder keeps authority and reports each outcome to
    the M7 event queue; app_dispatch routes reports to the machine last in
    each loop pass. After the queue drains, a disagreement with
    RadioRecorder_IsActive() is logged and recorded as the new
    SESSION_MISMATCH diagnostic fault.
    - Host tests: Session scenarios and shadow wiring through the real queue.
    - Delete session.md; its cross-region invariants become DEV-I3..I5 in
    top-lev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
2026-09-28 docs: back out CubeMX freeze edits swept into 0280530
    Commit 0280530 staged docs/design/cubemx-reconciliation.md and
    repository-layout.md by mistake. They are another in-progress change
    (CubeMX generation freeze) whose procedure file is not committed yet.
    Restore both to their state before 0280530; the edits stay in the
    working tree for their author.
2026-09-28 docs: accept decision 0008, recording-safe command policy (54w.1)
    Open-ended sessions that end on stop or a full card (with a reserve for
    one minute, one capture save and finalization); sleep, mode changes,
    Instrument engine switches, Playback and EMF calibration rejected during
    a session; Field scan-engine switches, capture save (Shift + Button 1)
    and allow-listed settings allowed; Shift lights only available actions;
    radio events acknowledged per Principle II without ending the session on
    a radio control fault.
2026-09-29 Implement first-slice gestures and Context machine (54w.3)
    Extend InputResolutionSm with clicks, holds, push-turn cancel, the Shift
    layer and the Button 0/1 chord group, emitting gestures. Add ContextSm
    for Field Classic and Manual pages, long-press engine and band menus,
    Instrument mode switch and the utility root with page restore, per
    decision 0009. Host tests cover P1-P15, navigation, and both machines
    through the event queue including overflow and reconcile.
2026-09-29 Post one reconcile per input loss (8lw.17)
    Count reconcile events queued but not yet dispatched. Input rejected
    while one is queued is covered by it, so a sustained burst no longer
    fills the internal reserve with reconciles (decision 0007 item 6).
    Queue and end-to-end tests cover the burst.
    [event_queue.c, event_queue.h, event_queue_test.c, input_context_test.c]
2026-09-30 docs: propose decision 0011, Halloween 2026 demo build
    Draft, status Proposed. Scopes a time-boxed demo track: product-grade work
    pulled forward on main, demo-only behavior behind an opt-in Demo preset on a
    separate branch, checkpoints and an end date. Depends on a separately proposed
    roadmap demo-track amendment, which is not applied here.
    Claude-Session: https://claude.ai/code/session_01Eqp2GyBkBmdgnxTZaja91p
2026-09-30 docs: accept decision 0011 and add the roadmap demo track
    User-approved 2026-09-30. Adds the time-boxed demo-track rules to the roadmap's
    Tracks section, accepts decision 0011 (Halloween 2026 demo build), and names the
    track-demo label in AGENTS.md and README.md. Beads epic full_spooky_proto-p04.
    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
2026-09-30 feat: portable audio sample timeline; propose decision 0012 (hpq.1)
    Off-bench slice of full_spooky_proto-hpq.1. Adds Common/audio_timeline:
    radio-frame stream positions per epoch derived from completed-half counts and
    the DMA down-counter, pending-completion resolution, radio/mic start
    alignment, offsets and event stamps with declared uncertainty. Host tests
    cover wrap, restart epochs, backwards counts and alignment. The module is not
    in any firmware source list, so Debug and Release images are unchanged.
    Decision 0012 (Proposed) defines the timeline, tolerances and the loopback
    qualification. The recorder start-path change stays gated on M1/M2 exit.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
    [audio_timeline.c, audio_timeline.h, audio_timeline_test.c]
2026-09-30 docs: accept decision 0012, common audio sample timeline (hpq.1)
    User accepted 2026-09-30. Status line and index only.
    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
2026-09-30 fix: harden target build identity evidence
    [fake.py, firmware.py, serial_io.py]
2026-09-30 fix: qualify UI service split
    [ui_board_test.c]
2026-09-30 docs: record IPC cold-start evidence (jjy.2)
    Power-removal cold start of a clean c4ab94c IpcSmoke pair: POR/BOR reset
    flags, boot epoch 1, IPC up 1009 ms after boot and progressing through a
    10 s recording. The ipc-load verdict failed on a 127 ms aggregate loop
    stall after RECORD START, tracked by 8lw.21.
2026-09-30 fix: exclude record-start pass from loop budget (8lw.21)
    The aggregate loop sample paired the capture state at the current loop
    start with the state latched at the end of the previous pass, after
    dispatch had started capture. The pass that opens and preallocates the
    file was charged as a recording pass (127 ms at RECORD START). Latch the
    capture state at each loop start, as foreground-latency.md specifies.
    Three 60 s recording regressions: two pass; one fails on a fully
    attributed 58 ms SD write (recorder 71/70 ms), tracked by 8lw.22.
    [main.c]
2026-09-30 fix: split recorder conversion from SD write (8lw.22)
    Block conversion (up to 15 ms in -O0, uncached images) ran in the same
    pass as f_write, so any write of 57 ms or more broke the 70 ms recorder
    budget. Convert in one pass and write in the next; budgets unchanged.
    Add RECORD LATENCY: write count, write and conversion maxima and an
    f_write histogram in 10 ms bins.
    600 s under IPC load: 7032 writes, max 56 ms, recorder 56/70, loop
    62/75, no violations; 60 s recording regression passes.
    [diagnostics.c, radio_recorder.c]
2026-09-30 feat: report sleep wakes and logger drain; record charging-sleep evidence (jjy.3)
    Each RTC sleep report now prints the WFI wake count, the result of the
    bounded UART7 drain before the previous sleep entry and the logger
    transport counters, so spurious wakes and drain aborts are observable.
    Bench: IpcSmoke rejects SLEEP START; Debug drains fully, first wake at
    10.1 s, then 300 s cadence, wakes equal reports, 3V3_VSYS ~20 mA awake
    and ~0 asleep, USER button returns through a software reset.
    [prototype_power.c]
2026-09-30 feat: finish non-blocking RadioSm radio control (54w.28)
    Complete the RadioSm work on top of the preserved WIP:
    - radio_adapter: a tune completion the event queue refuses is posted again
    on the next pass instead of later being reported as a failed tune, and an
    out-of-range band is refused before it can fault the radio.
    - tests: radio_control_test runs radio_control_service.c against a fake
    Si4735 on a fake I2C bus and tick: non-blocking issue, one status
    transaction per poll and the 2 ms poll interval, the 2 s completion
    timeout, the provisional 5 ms device-ready bound when the receiver is
    stuck, failed status reads, refusals, and band switches abandoning a tune.
    - docs: retire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
    [context_port.h, main.h, radio_adapter.c, radio_adapter.h, radio_control_service.c, radio_control_service.h, radio_control_test.c]
2026-10-01 docs: accept decision 0013, LED matrix EMF, radio-onset and status mapping (54w.8)
    Settles control map D-016 for the matrix, as decision 0011 item 8 requires:
    the expanding 2-pixel square with an optional trail, five EMF buckets
    (32/128/512/2048 uT starting boundaries) with colour and speed, transient
    row kicks from radio-audio onsets clipped at the edges, and a recording
    border that blinks with onsets and turns red on a fault.
    Claude-Session: https://claude.ai/code/session_012qypcbqUn2ubjkNMdF7ZeJ
2026-10-01 fix: keep the SD bus within default speed (jjy.7)
    The storage service mounted at CLKDIV 2 and then switched to CLKDIV 0,
    which bypasses the divider and runs SDMMC_CK at the full 75 MHz PLL1Q.
    The card is never switched to high speed, so the limit is 25 MHz. A 2 GB
    SDSC card failed data CRC on every directory read. Use CLKDIV 2
    (18.75 MHz) for mount and transfers.
    [fake.py, storage_service.c]
2026-10-01 test: qualify logger saturation during recording (jjy.6)
    Add the opt-in SPOOKY_LOGGER_LOAD_QUALIFICATION bench option. It adds
    LOG LOAD (paced 64-byte writes with DWT-timed latency and a histogram)
    and LOG FAULT (forces the 250 ms UART transmit watchdog abort). It is off
    in every normal preset.
    Record the bench evidence: logger overload up to ~13x line rate and UART
    faults during recording caused no overrun or budget violation, and
    counters reconcile exactly. USB backpressure can drop the recording
    outcome line (jjy.10).
2026-10-01 docs: record in-band tuning while recording bench evidence (54w.6)
    Three RadioTuneQual recordings (FM 90 s, AM 60 s, SW 60 s) with paced,
    stepped, back-to-back and flooded tunes: all PASS with exact accounting,
    queue high-water 1/8, no overruns, loop and recorder within budget.
    Records the receiver's tune mute in the raw radio track and the CDC input
    drop under a command flood (8lw.24). The guard on main is not lifted.
2026-10-01 fix: keep recorder outcome replies under USB backpressure (jjy.10)
    The recorder's four-line USB reply queue dropped the newest line when
    full, so a host that stopped reading for a whole recording lost
    OK RECORD PASS and RECORD DIAG and later received stale progress lines.
    Move the queue into CM7/App/reply_queue.[ch]: only the newest progress
    line stays queued, a reply that finds the queue full evicts a queued
    progress line, and only a queue full of replies loses its oldest reply
    (counted and still recorded as USB_BACKPRESSURE). RECORD LATENCY adds
    cumulative usb-superseded and usb-lost counters.
    Bench (image jjy10-replyq-20261001a): with CDC closed for a 60 s
    recording the target delivered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
    [radio_recorder.c, reply_queue.c, reply_queue.h, reply_queue_test.c]
2026-10-01 test: attribute recording-time foreground preemption to DMA interrupts (jjy.11)
    Add the opt-in SPOOKY_ISR_TIMING_QUALIFICATION build: it copies the M7
    vector table to RAM and routes SysTick and every external interrupt
    through a trampoline that times the original handler with the DWT cycle
    counter (inclusive/exclusive maxima, totals, interrupt bursts). ISR
    LIST/GET/BURST/RESET report the figures. Off in every preset.
    Bench: the 0.5-2 ms logger-write outliers seen only while recording are
    the DFSDM microphone DMA interrupt copying a 16 KiB block every 85 ms.
    At 64 MHz with caches off the bound is 3.4 ms exclusive (4.3 ms
    inclusive) per block and 0.85 ms per radio half in the Release image;
    1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
    [isr_timing.c, isr_timing.h, main.c]
2026-10-01 feat: add RECORD RESULT to recover a missed recording outcome (jjy.12)
    A host whose port open discards received data (pyserial on Windows
    calls PurgeComm in open()) loses the PASS/ABORT line the recorder sends
    on reconnect after a closed-port recording.
    Keep the last finished recording's outcome in CM7/App/recording_result
    and report it with the read-only RECORD RESULT query, accepted in every
    session state: seq, outcome, file, frames, bytes, elapsed, finalized and
    reason, or NONE before the first recording. The record is written before
    the outcome line is pushed.
    Bench (image jjy12-result-20261001a, stock pyserial open): after a 60 s
    recording with the port closed, RECORD RESULT returned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
    [command_policy_test.c, diagnostics.c, radio_recorder.c, recording_result.c, recording_result.h, recording_result_test.c]
2026-10-02 feat: add optional in-device SD format (jjy.14)
    SD FORMAT arms and SD FORMAT CONFIRM within 10 s erases the card with
    one FAT32 volume (32 KiB clusters). The storage service formats under a
    new FORMAT lease owner without mounting first, so cards with a damaged
    or foreign layout can be formatted, and refuses SDSC before writing.
    disk_ioctl GET_BLOCK_SIZE now reports the card's allocation unit from
    the SD Status register, so f_mkfs aligns the data area to it (it
    reported 1 before). Command policy rejects both commands while
    recording. FatFs _USE_MKFS is enabled; 8 KiB work buffer.
    Bench (image jjy14-format-20261001a): unarmed and expired confirms
    refused; a 16 GB SDHC card formatted in 2.0 s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
    [command_policy_test.c, diagnostics.c, ffconf.h, sd_diskio.c, sd_media.c, sd_media.h, sd_media_test.c, sd_test.c]
2026-10-02 feat: refuse SDSC recording and add SD INFO; propose decision 0014 (jjy.8)
    Draft decision 0014 (Proposed): SDHC/SDXC are the supported recording
    media for M1, in-device format is optional, overrun behavior is
    unchanged, every qualification records card identity and latency, and a
    storage margin warning is proposed. Allocation extents, deeper queues
    and nonblocking storage follow after M1.
    RECORD START now refuses an SDSC or unrecognized card before creating a
    file; reading, transfer and maintenance still work. SD INFO reads the
    CID and SD Status (manufacturer, product, date, speed class, UHS grade,
    video class, allocation unit) without mounting. Media helpers live in
    CM7/App/sd_media with h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
2026-10-02 feat: report a latched storage-margin warning while recording (jjy.8)
    Decision 0014 is accepted. Item 5: the recorder marks the storage margin
    LOW once either audio queue's high-water mark reaches 4 of 8 blocks or a
    single SD write takes 341 ms or more (half the queue headroom). It
    latches per recording, shows in RECORD STATUS and RECORD DIAG
    (margin=OK|LOW), and records one STORAGE_MARGIN diagnostic event; it is
    a warning, not a fault. Thresholds are build settings until the media
    survey (jjy.16) fixes them. Spooky Bench accepts the new RECORD DIAG
    field and still parses lines from older images.
    Bench: default thresholds give margin=OK on the reference card; images
    with the write threshold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
    [diag_history.c, diag_history.h, fake.py, ipc_load.py, radio_recorder.c, storage_margin.c, storage_margin.h, storage_margin_test.c]
2026-10-02 fix: bound SD card initialization for unresponsive cards (jjy.15)
    A card that never completes SD power-up blocked the foreground ~38 s per
    mount attempt: HAL_SD_Init retries ACMD41 up to 65,535 times before
    failing with the invalid-voltage-range error. The reported hal=0 hid
    this because the failed mount deinitializes the handle first.
    - Make SDMMC_MAX_VOLT_TRIAL overridable in the vendored LL header (HAL
    default unchanged) and set it to 2000 (~1.15 s, just over the SD 1 s
    power-up allowance) for the application and the generated
    STM32_Drivers library. Recorded as a local vendored change.
    - Wait at most 1 s for the transfer state after HAL_SD_Init instead of
    the 30 s data-transfer t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
    [radio_recorder.c, sd_diskio.c, sd_diskio.h, sd_test.c]
2026-10-02 test: record the rejected bounded preallocation search (jjy.9)
    A bounded FAT search that skipped f_expand when no contiguous run was
    found within 64 FAT sectors made RECORD START answer in 0.3 s instead
    of 1.5 s on a nearly full 16 GB card, but the file then grew
    dynamically and FatFs's free-cluster search stalled one write for
    1408 ms mid-recording: queue overrun, abort. The firmware keeps the
    current f_expand behavior; the jjy.9 plan is now a stepped search that
    completes before capture starts.
    Keep the host-tested FAT32 free-run scanner (CM7/App/fat_run, not yet
    linked into the firmware) for that plan, and the trial evidence.
    [fat_run.c, fat_run.h, fat_run_test.c]
2026-10-02 fix: prepare recording files in bounded steps before capture (jjy.9)
    RECORD START now mounts and checks the card and replies OK RECORD PREPARING;
    the recorder then names, creates and preallocates the file in ~32 ms
    foreground steps (SPOOKY_RECORD_PREPARE_STEP_MS), searching the FAT for a
    contiguous run with fat_run before f_expand. Capture starts on PREPARED, so
    no allocation search runs while recording. A start with no contiguous run is
    refused (free space too fragmented) instead of growing dynamically; RECORD
    STOP while preparing cancels and deletes the empty file. Preallocation is
    capped at the free space above the card reserve.
    SessionSm gains a Preparing substate of Active (recording c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
    [app_dispatch.c, app_events.h, command_policy.c, command_policy_test.c, fat_run.c, fat_run.h]
2026-10-02 fix: grow recordings only into free space verified ahead (jjy.17)
    A recording longer than its contiguous preallocation grows one cluster at a
    time, and FatFs then scans forward from the file's last cluster inside the
    block write; on a fragmented card that took 1.4 s and overran the queues.
    While recording, the recorder now reads the FAT ahead of the file in FatFs's
    allocation order, one sector per idle foreground pass and about 30 s ahead,
    counting the free clusters reachable across used stretches of at most
    SPOOKY_RECORDING_MAX_GAP_FAT_SECTORS (16). The recording may fill only that
    verified space; at a barrier it finalizes with "free space fragmented".
    Adds the FatRunway scanner, a Recordi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
    [fat_run.c, fat_run.h, fat_run_test.c, radio_recorder.c, recording_limits.c, recording_limits.h, recording_limits_test.c, storage_service.c]
2026-10-02 docs: add storage stall headroom to M4 scope and exit (approved)
    User-approved roadmap amendment (2026-10-02). jjy.13, jjy.16 and jjy.18 came
    out of M1 qualification but depend on M4 decisions: session folders (hpq.3),
    the rolling-capture buffer design (hpq.2), and the media contract that M4's
    no-overrun exit needs. Decision 0014 already places items 6-7 after M1; item
    8 (nonblocking storage) stays outside M4. Beads: the three tasks relabelled
    m1 -> m4 and moved under the hpq epic.
2026-10-02 fix: USB command flow control, host-less recording replies, live battery reads (8lw.24, 8lw.20, 8lw.19)
    8lw.24: the CDC OUT endpoint is re-armed only while the 256-byte command
    ring has room for another 64-byte packet (CM7/App/cdc_rx_flow.c), so a fast
    host is NAKed instead of losing or merging bytes. The HAL unmasks an
    interrupt for every NAKed OUT token; it is masked at configuration, since
    with it a paused endpoint starved a recording into an overrun. DIAG USB
    reports the receive counters.
    8lw.20: the recorder queues replies only while a host has the CDC interface
    configured and discards queued lines when the host goes, counting both as
    usb-detached instead of USB_BACKPRESSURE faults.
    8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
    [board_diagnostics.c, board_diagnostics.h, cdc_rx_flow.c, cdc_rx_flow.h, cdc_rx_flow_test.c, diagnostics.c, fuel_gauge_test.c, fuel_gauge_test.h]
2026-10-02 feat: decision 0013 matrix feedback as portable host-tested code (54w.8)
    Add the EMF level (buckets and explicit unknown states) and the radio
    onset detector on the M7, and the portable 9x9 matrix renderer in
    Common. Host tests cover bucket boundaries, staleness, onset sizes and
    re-arming, held averages while the radio is not measuring, loop
    geometry, kick shift, clipping and decay, and the recording and fault
    borders. The modules are linked but not yet called by the firmware.
2026-10-02 docs: accept decision 0015, raw radio track during in-band tunes (54w.6)
    Answers decision 0003 question 4. Receiver output during an in-band tune
    is stored as delivered; the Radio machine marks each tune with start and
    end events on the decision 0012 timeline; the retune interval (plus a
    per-band settle margin) is receiver output that is not a measurement of
    the radio signal. The in-band guard on main stays until question 5.
2026-10-02 feat: align recording start on the radio sample timeline (hpq.1)
    Decision 0012 items 2 to 4. The radio stream starts a timeline epoch at
    DMA index 0; StartMonitor no longer zeroes the half counters mid-stream,
    so their parity tracks the half the DMA fills. RECORD START now takes a
    radio position snapshot, enables radio capture and starts the DFSDM DMA
    with interrupts masked, and the recorder drops radio frames before the
    origin (snapshot + C, C = SPOOKY_RECORD_MIC_LATENCY_FRAMES, 0 until the
    item 9 loopback measures it). RECORD TIMELINE reports the epoch, origin,
    p, skip and the SAI2 RX / SAI1 TX phase for that qualification. The SAI
    callbacks gain no work. Not yet bench-qualified.
    Co-Autho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
    [audio_path_service.c, audio_path_service.h, audio_timeline.c, audio_timeline.h, audio_timeline_test.c, radio_recorder.c]
2026-10-03 feat: Classic scan engine spec, decision 0016 and C-110/C-111 (54w.7, 54w.31)
    Ratify feature spec 001 (Classic scan engine) after clarification: band
    and frequency shared by every Field engine and Manual, per-band jump
    distance, wrap/bounce/stop edge behavior, activity hold on Encoder 3.
    Accept decision 0016 (Classic scan motion, band edges and activity
    hold): channel arithmetic, rate and distance tables with per-band
    limits from the 2026-10-01 tune evidence, the jump schedule, edge
    rules, the onset-based hold and the unable-to-scan state. It supersedes
    decision 0009 item 11 for the Classic page, noted on 0009's status line.
    Apply the approved control-map proposal: C-110 (Encoder 2 turn se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
2026-10-03 docs: evidence for recording start alignment on the radio timeline (hpq.1)
    Recording regression pass on e73ce45; decision 0012 item 9 loopback set:
    same-boot and cross-boot lag within 1.4 frames on the positive phase,
    0 frames drift over 600 s; C not separable from the output-path delay.
2026-10-03 docs: accept decision 0017, microphone start latency stays uncompensated (hpq.1)
    C stays 0: the acoustic loopback cannot separate it from the output-path
    delay. Start alignment is qualified as repeatability (0.3 frames same
    boot, 1.4 frames across a reset, 0 frames drift over ten minutes); the
    absolute radio-microphone offset is stated as unmeasured. Decision 0012's
    status line notes the amended items.
    [radio_recorder.c]
2026-10-03 feat: Classic scan engine core with host tests (54w.7)
    Add classic_scan, the portable Classic engine core from spec 001 and
    decision 0016 items 1 to 15 and 22: channel arithmetic over the current
    band, the rate table with per-band maximum rates and the limited-rate
    rule, a drift-free jump schedule that waits for a tune in flight and
    never catches up in a burst, the distance table cut at half the band
    with per-band memory, and wrap, bounce and stop with the resume-on-edge
    rule. Band and frequency are passed in from shared tuning and never
    stored; sweep complete is derived from position and direction. All
    decision 0016 values live in one ClassicScanConfig.
    Host tests cover SC-002 (every band,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
    [classic_scan.c, classic_scan.h, classic_scan_test.c]
2026-10-03 feat: run Classic on the M7 with CLI control and published events (54w.33)
    Add classic_service, which runs the classic_scan core each foreground
    pass against the shared radio and session state. Jumps go to the Radio
    machine as internal tune commands through the event queue, only when
    the shared command policy allows in-band tuning and the radio is
    running; otherwise Classic publishes "unable to scan" with the reason
    and does not retry. It waits while the radio is tuning, while its own
    command is unanswered, and while a CLI radio command is unanswered.
    Every change of run state, direction, rate, distance or edge behavior
    is published as one event.
    classic_adapter wires it to RadioControl, Ra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
2026-10-03 feat: Classic activity hold and the M7 radio onset feed (54w.32)
    Classic holds on a landing while radio onsets continue (decision 0016 items
    16 to 20): hold time 0 to 30 s on Encoder 3 (C-111, CLASSIC HOLD n), trigger
    medium, release 1.5 s, at most one hold per landing, published HOLDING run
    state, HOLD_TIME event and hold count. A hold only lengthens a dwell.
    radio_activity_feed runs the decision 0013 onset detector on the live radio
    stream: the capture callback posts one level per half-buffer into a 32-entry
    ring (drop newest, counted), and the foreground marks decision 0015 retune
    intervals and a stopped radio as not measuring. New ACTIVITY foreground slot,
    CLASSIC ACTIVITY diagnostic an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
2026-10-03 fix: keep host test checks active in the Release build (hqc)
    storage_lease_test used assert() for every check, and the documented host
    build is Release, where NDEBUG compiled them all out. Convert it to the
    always-on CHECK idiom, make the fake HAL's output bound an explicit check,
    and strip NDEBUG from the test project's build-type flags so any future
    assert() still checks. ipc_smoke_protocol_test already used CHECK; its only
    asserts are _Static_asserts.
    Host tests 28/28 in Release; a deliberately broken CHECK and a deliberately
    broken assert() each fail ctest.
    [fake_hal.c, storage_lease_test.c]
2026-10-03 fix: radio capture interrupts below SysTick so recordings keep time (akw)
    The radio half-buffer interrupt (DMA1_Stream4) now takes about 1.2 ms per
    run in the Debug image while recording, longer than the 1 ms tick period.
    At SysTick's own priority it blocked the tick, and recordings lost 2.6 to
    3% of their elapsed time, failing the recording regression's
    recording_duration check. DMA1_Stream4 and SAI2 move to priority 1: the
    tick can preempt them, and the radio still preempts the microphone copy.
    Measured with the ISR timing build on main and on the fix; the 60 s
    recording regression passes on the fix. Moving the work out of the DMA
    interrupts stays with jjy.13.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
    [audio_path_service.c]
2026-10-03 feat: decision 0013 matrix feedback on the M7, decision 0019 (54w.8)
    The M7 drives the IS31FL3741 matrix from the portable renderer:
    matrix_writer diffs each frame against the matrix and hands out changed
    rows as register runs, correcting for the matrix being mounted rotated 180
    degrees; matrix_service feeds the renderer the EMF level, radio onsets and
    Session events; matrix_adapter writes runs over I2C2 for up to 2 ms per
    pass in a new MATRIX foreground slot. Feedback is off at boot
    (UI MATRIX FEEDBACK ON|OFF, UI MATRIX TRAIL ON|OFF); UI MATRIX ORIENT
    shows the mounting. On normal images the matrix is switched off through its
    enable pin while the recorder captures; the opt-in
    SPOOKY_MATRIX_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
    [classic_adapter.c, command_policy.c, command_policy_test.c, diagnostics.c, emf_level.c, emf_level.h, emf_level_test.c, foreground_budget.c]
2026-10-03 fix: matrix grey and recording yellow drive values from the bench (54w.8)
    On the IS31FL3741 the unknown-EMF grey (55, 58, 62) looked pale orange and
    the recording border (230, 200, 40) orange, because red reads strongest. The
    user picked new drive values from on-matrix candidate grids: grey (1, 2, 2),
    the faintest step of a neutral mix, and yellow (120, 240, 10), clearly apart
    from the amber bucket. Checked in context on the qualification image during
    recordings. Renderer tests keep a visible stand-in grey for geometry and
    check the default drive value separately.
    Host tests 30/30; Debug and Release build.
    [matrix_feedback.c, matrix_feedback_test.c]
2026-10-05 docs: propose Instrument engine and demo-scope decisions 0020-0024
    Draft decision records (status Proposed) from the 2026-10-05 design
    conversation, for the user to work through:
    - 0020 Halloween demo scope: Slicer and a sequencer view per engine,
    tempo hue rotation on the matrix (supersedes 0011 item 16 on accept)
    - 0021 Instrument engines own their performance-view semantics
    - 0022 Slicer engine: slice map, slice page and sequencer
    - 0023 Clip selection, region editing and the empty Instrument
    - 0024 Clip sources, track mixing and maximum clip length
    Items are marked as user-agreed or agent proposals; each record lists
    open questions. Decision tasks: p04.13, v7l.8-v7l.11.
    Co-Authored-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
2026-10-05 docs: resolve decision 0020 open questions
    Record the user's calls on delivery order, the per-engine matrix (grain
    activity for Granular, hue rotation for Slicer), the slice-page cut order,
    checkpoint gates and the empty Instrument state. 0021 follows the matrix change.
    Claude-Session: https://claude.ai/code/session_01D9JCqxkHUo3fcTGtziiNpN
2026-10-06 docs: record the user's calls on decision 0021
    Transport on Encoder 0 click, shared matrix layers, shared modulation sources
    with engine-owned targets, one global FX chain outside presets, global swing,
    the sequencer as a stepped modulation source, and audio-first Instrument
    recording. One-shot MIDI and microphone injection are deferred. Three small
    questions remain. The Beads migration batch adds the v7l.8 note.
    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
2026-10-06 docs: settle the last open questions in decision 0021
    Transport runs on Encoder 0 click on the main engine page and Encoder 2 click
    inside performance views (provisional). The gesture list is confirmed, and an
    engine-drive pattern setting offers value and trigger, trigger only, or none.
    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
2026-10-06 docs: record the user's calls on decision 0022
    Agreed: edit limits, audition, confirmed count changes, time-based remap,
    silent disabled slices, slice map storage, rate pitch, editable start,
    slice-relative gate, the extras order, a shell-level shuffle and the MIDI key
    map. Probability, ratchet and shuffle details await confirmation.
    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
2026-10-06 docs: record the user's calls on decision 0023
    The region editor gets a waveform and event timeline with zoom, event jumps
    and a full control table; failures, recording safety, clip references, limits
    and the C-010 failure are settled. The Beads batch adds a peak-track
    requirement on hpq.3 and a progress note on v7l.10.
    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
2026-10-07 docs: accept decisions 0026 and 0027
    0026: every clip load fits the tempo and every pattern's division so 16
    steps span the clip at 70-140 BPM; tempo and a fixed 4/4 meter belong to
    the transport, division and length to each pattern; the demo gains a
    Tempo and Division settings row. It supersedes the one-bar BPM on load in
    0020 item 9 and 0022 item 10, whose status lines now say so.
    0027: engine switches are immediate with a short crossfade, pattern
    playheads follow the transport, a switch lands on the new engine's main
    page, and Granular starts with a 16-step sweep of the clip. Its change to
    modes-and-interaction Remember Context is proposed via v7l.12.
    Beads: p04.19 and p04.20 closed; ba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
2026-10-09 docs: SD card wedged by the power-up order, and battery-first setup
    Four cold-start trials: cables connected before the battery switch hung
    an SD write about 2.6 s into the boot and wedged the card (2/2, from
    Instrument and Field); battery first passed (2/2, both modes). The mode
    at power-down made no difference. The bench setup procedure now says to
    switch the battery on before connecting either USB cable.
2026-10-09 feat: monitor-only PTT fades the radio out of the monitor (54w.9)
    PTT ramps the monitored radio to silence over 240 frames (5 ms) and back
    on release; the raw capture is copied before the monitor stage and is
    never touched. The ramp is a portable module in Common with host tests.
    AudioPath_SetPtt stamps each press and release on the radio timeline as
    a foreground observation, and MONITOR / MONITOR PTT ON|OFF report and
    set it through COMMAND_ACTION_PTT, allowed in every session state. The
    microphone is not monitored (decision 0028).
2026-10-09 docs: monitor-only PTT bench evidence (54w.9)
    CLI PTT silenced the radio in the monitor with no audible click, and a
    30 s recording kept the raw radio track unchanged through three PTT
    intervals.
2026-10-09 feat: opt-in SpeakerMonitor experiment, speaker default with headphone override (jr0)
    SPOOKY_SPEAKER_MONITOR (SpeakerMonitor preset, off everywhere else) powers
    SGTL5000 line out to drive the PAM8302 on J5. With no headphones, the monitor
    plays on the speaker and the pot sets the DAC volume; a debounced PE0
    insertion moves it to the headphones. AMP_SD (PG8) becomes open drain and is
    released only while the speaker is selected and unmuted. Spooky Bench accepts
    SpeakerMonitor manifests.
2026-10-09 feat: stamp tune start and end on the radio timeline; wav retune analysis (54w.6.1)
    Decision 0015 items 2-3: the radio adapter stamps each issued tune with
    AudioPath_GetPosition before RadioControl_BeginTune and again when its
    outcome (TUNED, FAILED, ABANDONED) is published, and logs one [retune] line
    with both epoch:frame stamps. A tune that cannot be issued logs nothing.
    Session storage stays with hpq.3.
    Spooky Bench gains the offline `wav retune` command for the item 10
    qualification: every exact-zero radio run of at least 1 ms after the first
    tune must overlap a stamped tune; per-band settle margins are the largest
    overhang past the end stamp, rounded up to 512 frames.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
    [cli.py, radio_adapter.c, wav_retune.py]
2026-10-09 feat: per-band retune settle margins from the item 10 qualification (54w.6.1)
    RadioActivityFeed_OnRetuneStart takes the interval's settle margin; adjoining
    intervals keep the larger one. The radio adapter passes 0 for FM and AM tunes
    (decision 0015 item 10, docs/evidence/2026-10-09-retune-qualification.md) and
    the starting one half-buffer for SW, LW and band switches, which are not
    qualified yet. Host tests cover a zero margin and adjoining margins.
2026-10-09 docs: decision 0030, Field session folder, manifest and event log (hpq.3)
    Accepted 2026-10-09. Every recording becomes /FIELD/Fnnnn with a bounded
    MANIFEST.TXT, contiguous AUDIOnnn.WAV parts and a versioned 32-byte binary
    event log (EVENTS.BIN) on the session timeline: session, tune, gap, PTT,
    Classic and events-lost records with reader rules for range, frame-0 state,
    order and loss resync. Byte layouts and examples in
    docs/design/session-format.md. Revised for the Codex review in hpq.3's notes.
    Product open decision 14 now marks semantic events resolved by 0030
    (approved proposal hpq.9); EMF, activity and sequencer/MIDI stay open.
2026-10-10 docs: PAM8302 gain trim evidence; record trim at maximum
    The speaker was silent because the board held the RadioTuneQual image, which
    keeps line out off and AMP_SD low. The SpeakerMonitor image restored it, and
    the operator set the PAM8302 gain trim to maximum with no faults heard.
2026-10-16 docs: babysitter swap and enclosure regression evidence (lin)
    Record the 2026-10-16 hardware regression after the Battery Babysitter
    replacement and the rebuild into the speaker/SD-extender enclosure: recording
    regression, SD basic through the extender, babysitter VBUS/charge/gauge, UI,
    magnetometer, headphone, speaker and microphone pass; FM inconclusive in the
    basement (recheck in full_spooky_proto-jn8). List the enclosure and SD slot
    extender in the prototype hardware configuration.
2026-10-16 docs: record operator confirmation of the LED chase (lin)
2026-10-16 feat: Field session folders and manifest (decision 0030, hpq.10)
    Every recording now prepares /FIELD/Fnnnn in bounded steps: the folder number
    comes from /FIELD/INDEX.TXT (a missing index searches from 1), MANIFEST.TXT is
    written with state=recording before the audio file, and AUDIO000.WAV holds the
    audio. Finishing rewrites the manifest with state=ended, the end reason, the
    frame total and the timeline origin; a failed rewrite reports the session as not
    finalized. A start that never captures removes its files and folder. The session
    still ends at the WAV size limit with audio_parts=1 until hpq.12.
    session_files.[ch] holds the portable names, index and manifest text with host
    tests; the rad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
2026-10-16 docs: Field session folder bench evidence (hpq.10)
    The M1 recording regression passes on the session-folder path, including its
    new manifest stage. Folders number in order from INDEX.TXT, a start cancelled
    after its folder existed leaves none, a deleted index rebuilds by searching from
    1, and every fetched manifest is ended with the recorder's frame count. Folder
    creation takes one 65-91 ms FatFs call before capture (noted on jjy.18). Button
    0 was not exercisable on the Debug image.
2026-10-16 feat: session event log, EVENTS.BIN (decision 0030, hpq.11)
    session_event_log.[ch] (portable, host-tested): 32-byte record and header
    encoding, a 64-record queue that drops the newest and counts it, an
    events-lost record and resync request before the next accepted record, the
    session-frame conversion with clipping, and sector assembly with a 2 s sparse
    flush. session_events.[ch] posts session start with the frame-0 state (Classic
    snapshot, PTT, a tune in flight), tune start and end from the radio adapter,
    PTT from the audio path and every Classic event, all on the session timeline.
    The recorder creates EVENTS.BIN with its header while preparing, writes due
    sectors only in passes without aud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
2026-10-16 fix: a tune open at session end runs to session end in the event reader (hpq.11)
    A tune still in flight when a session ends has no tune-end record, because its
    end is observed after the last frame (decision 0030 item 10). The reader paired
    only closed tunes, so the AM qualification's final zero run looked unexplained.
    session_events.tunes() now closes such a tune at session end, and the reader
    rules in session-format.md say so.
2026-10-16 docs: session event log bench evidence (hpq.11, decision 0030 item 20)
    Regression passes with the events stage. FM at 400/min with bounce edges and
    AM at 180/min wrote 1,007 and 366 records with none lost; every tune and
    Classic event matches the UART log at the same session frame; the retune
    check from EVENTS.BIN finds every zero run inside a stamped tune with no
    overhang on either band. Answers Q5 for 54w.6.
2026-10-16 feat: lift the in-band tune guard while recording (54w.6, decision 0003)
    In-band tuning (TUNE, UP, DOWN and Classic's jumps) is now allowed in every
    session state through the shared command policy. Decision 0003's questions are
    answered for tuning: continuity, timing and scan rate by the 2026-10-01 bench,
    raw-track meaning by decision 0015, event storage by the session event log
    (hpq.11), failure isolation and bus ownership accepted on host-test coverage.
    Band changes stay rejected while recording until 54w.12, now with the reply
    "ERR RADIO band changes disabled while recording".
    The opt-in RadioTuneQual preset and its policy-test variant are removed (Spooky
    Bench still accepts archived Rad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
2026-10-16 docs: in-band tune guard lift bench evidence (54w.6)
    Normal IpcSmoke and Debug images with tuning allowed while recording: the
    regression passes with Classic scanning through it; FM, AM and SW sessions pass
    with exact accounting, queues at most 1/8, no lost events and no faults; CLI
    TUNE/UP/DOWN are accepted mid-recording and BAND is refused with the new reply;
    every event matches the UART log. FM passes the retune check from EVENTS.BIN.
    One AM zero run lies outside every tune: near-silent receiver output 10 ms
    after a tune, filed as itn. SW had no usable signal.
2026-10-16 feat: silence fill and exact gap events during band switches (54w.12.1, decision 0004)
    While the audio path's stream gate is closed, each radio half-buffer now
    reaches the recorder as digital silence of the same length, so the radio and
    microphone keep the same block count, and the monitor plays silence; the
    activity feed still gets no measurement. radio_gap.[ch] (portable, host
    tested) records the silenced blocks; the radio adapter reports each gap edge
    once as exact gap start/end records in EVENTS.BIN and a [gap] UART line.
    The opt-in BandSwitchQual preset (SPOOKY_RADIO_BAND_QUALIFICATION) allows band
    changes while recording for the 54w.12 bench only; normal builds keep the band
    guard. `w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
2026-10-17 fix: never write an event record past the session's audio (hpq.13)
    The WAV lags real time by a block or two, so a stamp taken while the last
    block waits could fall after the session's last frame, and the log wrote it
    (found on the 54w.12.1 bench: a tune end 2,052 frames past the end). The
    writer now takes only the leading records whose frame is already in the audio
    file (below frames_written), and session end drops waiting records after the
    last frame, lowering later sequence numbers by the records dropped before them
    so the drop does not read as a loss (decision 0030 item 10).
2026-10-17 feat: wav retune splits mutes at gaps and counts unexplained runs per band (54w.12.1)
    A tune's mute that runs straight into a band-switch gap is one zero run; the
    part inside the gap is now explained by the gap instead of being counted as
    tune overhang. Each unexplained run carries the band in effect (from session
    start and each gap end), and the result counts them per band, so SW or LW
    without reception no longer hides whether FM and AM are clean.
2026-10-17 docs: band-switch silence fill and gap event bench evidence (54w.12.1, hpq.13)
    Four 60 s BandSwitchQual sessions with five band switches each record with
    exact accounting and no overrun; gap records match the UART lines exactly and
    every checked gap is exact silence on both radio channels. The bench found an
    event record past the session's last frame, fixed by hpq.13 and confirmed by a
    rerun at 400/min. The blocking switch still costs up to 349 ms of foreground
    and 4-5 of 8 recorder blocks (54w.12.2).
2026-10-17 docs: propose decision 0031, encoder and button lights flash on radio onsets
    Settles the direct-LED expression of radio activity left open under 54w.8:
    lit controls pulse brighter on each decision 0013 onset in Field, sized by
    the onset and decaying like a matrix kick, never in the prompt, in Shift
    or in Instrument. Proposed for the user's review; the demo implements it
    on top of p04.12.
    Claude-Session: https://claude.ai/code/session_01JZzFVKHM53Y91r2yLLUMkQ
2026-10-17 feat: lights reader and radio onset flash envelope (54w.8.1, decision 0031)
    Accepts decision 0031 (user, 2026-10-17). Adds a third onset feed reader
    for the lights, so flashes never take onsets from Classic's activity hold
    or the matrix, and a portable flash envelope in Common: a small, medium
    or large onset boosts a light by one, two or three thirds of its headroom
    and the boost falls one third per 80 ms, like a matrix kick; a smaller
    onset than the flash in progress is ignored. Host tests for both.
    presentation.md gains PRES-LED-07 and narrows the open LED row to EMF and
    warnings. No lights renderer calls the envelope on main; the demo image
    consumes it in p04.27.
    Beads writes (54w.8.1, p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
2026-10-17 docs: timer channel and alternate function of each UI LED pin (p04.12)
    Records the decision 0005 consequence for the demo encoder PWM work: every
    button and encoder LED channel, its timer channel and AF number, from the
    .ioc signals and the HAL AF table.
    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
2026-10-17 feat: non-blocking band switch in the radio state machine (54w.12.2)
    The radio control service performs the proven band-switch sequence as polled
    steps: RadioControl_BeginSwitchBand starts it without touching the bus, and each
    RadioControl_PollSwitchBand call does one status read and at most one command
    write, or one status poll of the first tune. The 71 ms of fixed delays and the
    2 s device waits elapse between foreground passes.
    RadioSm gains a Switching state. Commands wait latest-wins behind a switch as they
    do behind a tune; a tune held behind a switch is range-checked against the new
    band. BAND_DONE publishes BAND_CHANGED; BAND_FAILED faults the radio and answers
    the waiting command.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
2026-10-17 fix: let the Radio machine range-check CLI tunes (54w.12.2)
    The CLI checked a TUNE frequency against the band at parse time, so a TUNE sent
    right after BAND was rejected against the old band before the queued switch ran.
    The Radio machine already checks the range against the band the tune will run
    in, and answers ERR <band> range itself.
2026-10-17 perf: read a band-switch command's reply in the poll that wrote it (54w.12.2)
    The first bench showed each band switch's gap 100-220 ms longer than with the
    blocking switch: every command and its reply took separate foreground passes,
    and every fixed delay rounded up to a pass boundary before the next command.
    A poll now reads the reply right after writing the command, and the poll that
    ends a delay writes the next command. A poll still writes at most one command,
    with a status read before and after it, and never waits.
2026-10-17 docs: non-blocking band switch bench evidence (54w.12.2)
    Two BandSwitchQual images, four 60 s sessions with five band switches each:
    loop within its 75 ms budget (max 58 ms), dispatcher max 6 ms, recorder queues
    1/8, margin OK, no HAS_FAULT. Event logs match the UART log and the F0023 gaps
    are exact silence. Gaps are 50-150 ms longer than with the blocking switch.
2026-10-17 feat: a failed band switch keeps the session recording (54w.12.3)
    User decision Q6 (54w.12): a band switch that fails holds the receiver in reset
    and keeps the output muted, but no longer marks the audio path stopped. Radio
    capture keeps running with its stream gate closed, so each radio block reaches
    the recorder as silence, the microphone track continues, and the decision 0004
    gap stays open with no end; readers close it at session end.
    - A RADIO_FAULT diagnostic (event 20) records the fault and sets HAS_FAULT.
    - Until reset, STATUS and every radio command answer
    ERR RADIO band switch failed; reset required, and RECORD START is refused.
    - RadioControl_PowerDown skips a receiver held in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
2026-10-17 fix: a session may start while a band switch is in flight (54w.12.3)
    Capture alignment refused a closed stream gate because gated halves once were
    not delivered. Since the silence fill (54w.12.1) they reach the recorder as
    silence, so the check is stale; with the non-blocking switch (54w.12.2) it made
    RECORD START during a band switch abort with "radio timeline unavailable". The
    session now starts inside the gap and gets its frame-0 gap start (decision 0030
    item 11).
2026-10-17 docs: failed band switch during a session, bench evidence (54w.12.3)
    An induced band-switch failure 15 s into a 40 s session: the recording passes,
    the radio channels hold exact silence to the end with the gap left open, the
    microphone continues, and the fault shows in replies, STATUS, Classic,
    HAS_FAULT and DIAG LAST. Sessions started inside a switch begin with a frame-0
    gap start once capture alignment allows a closed gate.
2026-10-17 feat: publish band switch started (PRES-RAD-06, 54w.12.4)
    User decision Q7 (54w.12): the Radio machine publishes RAD_PUB_BAND_STARTED when
    a band switch has begun, with the command in flight, alongside the existing
    completed (BAND_CHANGED) and failed (FAULT_BAND) events. Like TUNE_STARTED it
    does not answer the command, so the CLI keeps one reply per command. On main it
    is acknowledged by a "[radio] band switch started <from>-><to>" log line and the
    monitor's mute; display and lights render it with 54w.5.
2026-10-17 docs: band switch started, completed and failed events, bench evidence (54w.12.4)
    Seven switches on the BandSwitchQual image: each announced as started once and
    before its outcome, a superseded command never announced, and one CLI reply per
    command, including an induced failure.
2026-10-17 feat: lift the recording guard on band changes (54w.12)
    Decision 0003: band changes are legal in every session state, like in-band
    tuning since 54w.6. Its questions were answered by 54w.12.1-.4 (silence fill
    and gap events, the non-blocking switch, failure isolation and the band switch
    events). The BandSwitchQual preset now only adds BAND FAIL fault injection; the
    band-qualification variant of the policy test is gone. DEV-I4's deviation row is
    removed and the CLI and behavior docs say band changes are allowed while
    recording. Bench evidence: docs/evidence/2026-10-17-band-guard-lift.md.
2026-10-17 docs: band guard lift qualification evidence (54w.12)
    A 600 s session on a normal Release image with 71 band switches through all four
    bands while Classic scanned: PASS with exact accounting, queues 1/8, margin OK,
    loop max 47 ms, no faults; every switch announced, completed and stored as an
    exact gap of digital silence matching the UART log.
