dwight9339/spooky_box_proto/(notices)

Notices in the files:
CM7/Core/Inc/main.h:
Copyright (c) 2026 STMicroelectronics.
All rights reserved.
This software is licensed under terms that can be found in the LICENSE file
